jthompson2710/FireTIRS/README.md

# FireTIRS

This respository contains the hardware and software produced during the development of the Fire Thermal InfraRed Spectrometer (FireTIRS) imaging instrument as part of a NASA ESTO FireTech project (grant: 80NSSC23K1544)
