jthompson2710/FireTIRS/enclosures/readme.md

## FireTIRS Enclosures
This directory contains the design files for various enclosures used in the FireTIRS project.

### Zumlink Z9 T2 Enclosure
A simple 3D printed Freewave Zumlink Z9 T2 base station enclosure.  Designed using OpenSCAD and includes the generated STL.

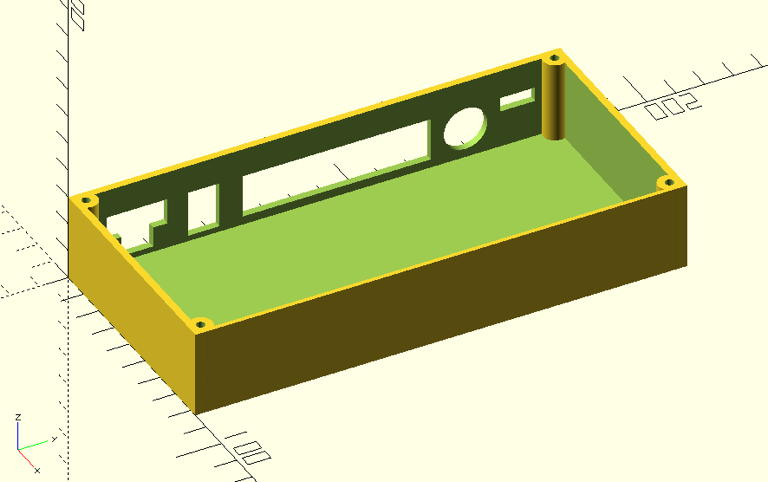
[picture p12: enclosures/pictures/t9_t2_encl_render.jpg]
Z9 T2 OpenSCAD render


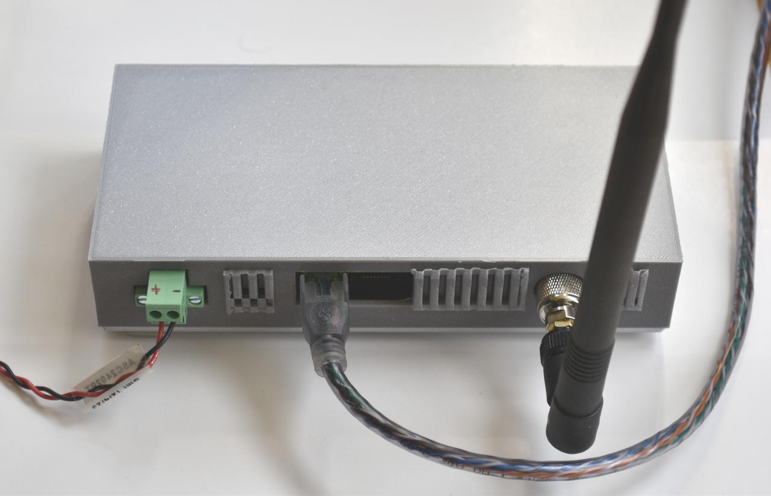
[picture p13: enclosures/pictures/z9_t2_enclosure.jpg]
Z9 T2 in enclosure


### FireTIRS UAV Enclosure
A 3D printable enclosure.  Designed using AutoCAD and includes the generated STLs.

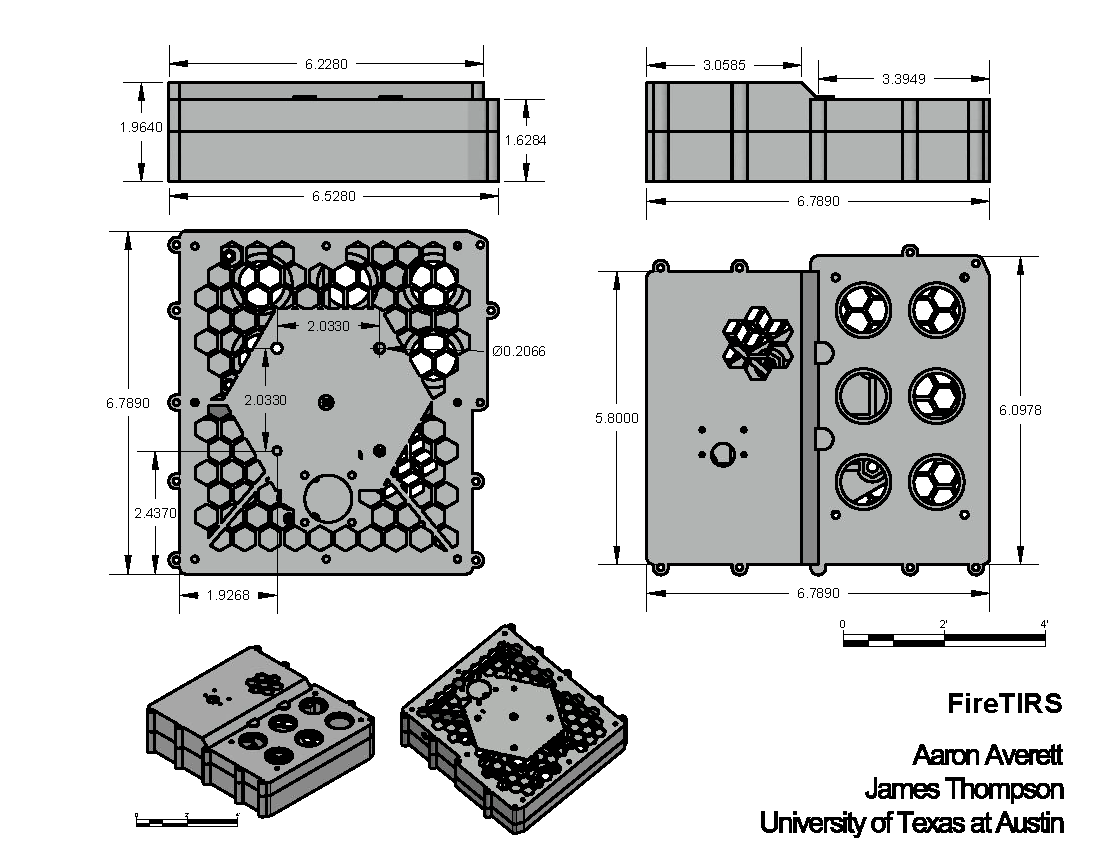
[picture p14: enclosures/pictures/FireTIRS_Dimensional.png]
FireTIRS Dimensional Render


FireTIRS enclosure base

FireTIRS enclosure top

FireTIRS enclosure filter retainer
