jthompson2710/FireTIRS/enclosures/pictures/housing_top.stl

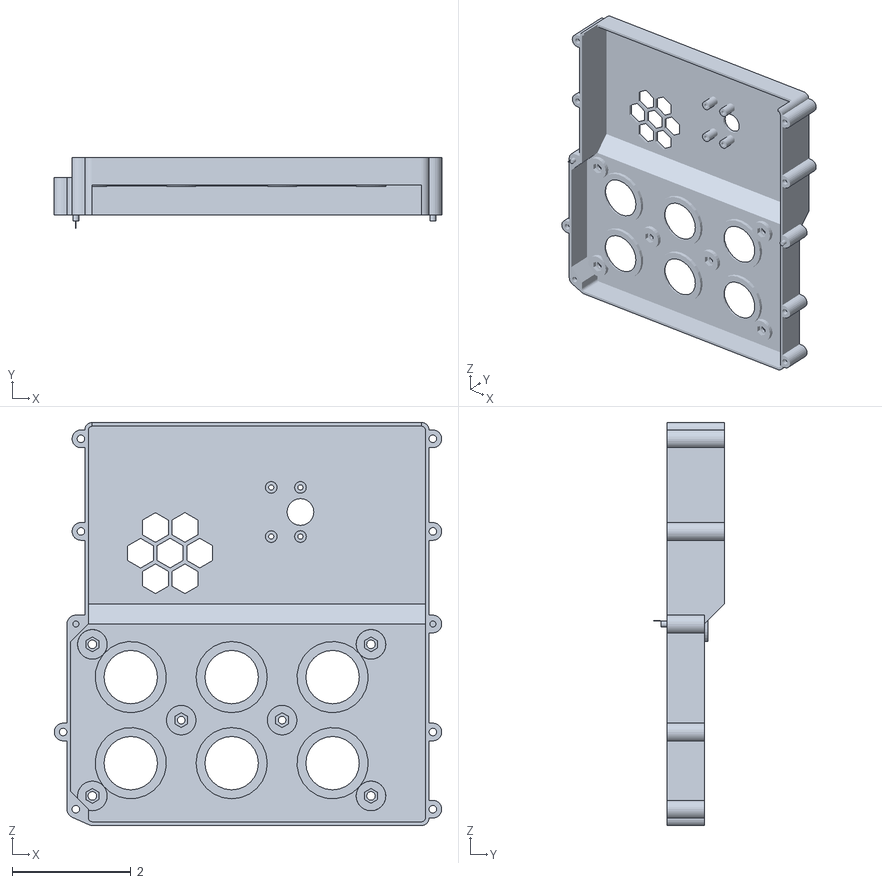
[picture p15: CAD file, 2025-01-29]
enclosures/pictures/housing_top.stl
6.53 x 1.19 x 6.79
