jthompson2710/FireTIRS/enclosures/z9_t2_enclosure/z9_t2_enclosure.stl

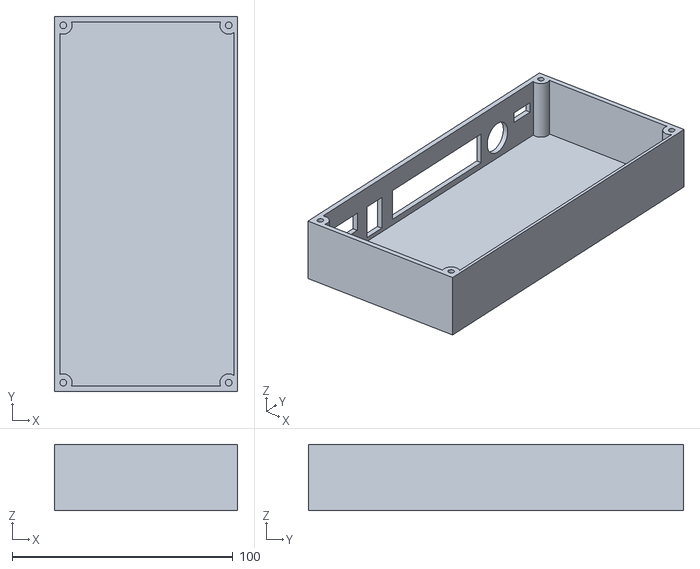
[picture p16: CAD file, 2024-07-04]
enclosures/z9_t2_enclosure/z9_t2_enclosure.stl
83.0 x 170.0 x 30.0
