jthompson2710/FireTIRS/enclosures/pictures/retainer.stl

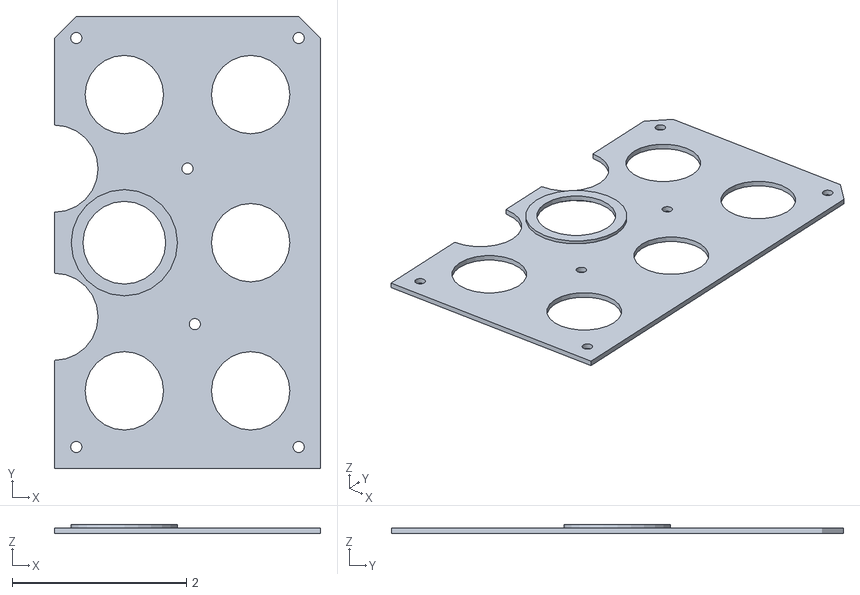
[picture p17: CAD file, 2025-01-29]
enclosures/pictures/retainer.stl
3.05 x 5.19 x 0.102
