jthompson2710/FireTIRS/enclosures/pictures/housing_base.stl

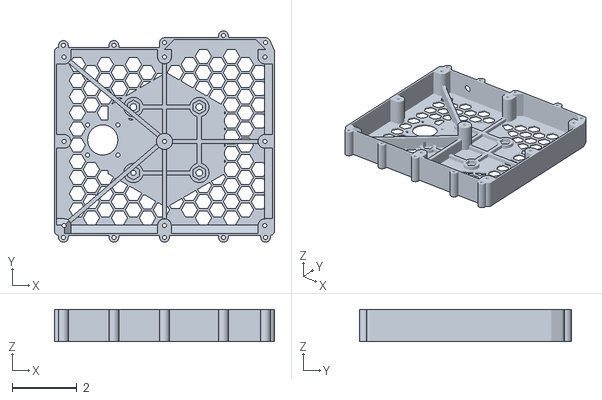
[picture p18: CAD file, 2025-01-29]
enclosures/pictures/housing_base.stl
6.79 x 6.53 x 1
