jthompson2710/FireTIRS/hardware/pcb_assembly/documentation/firetirs_pcb.pdf

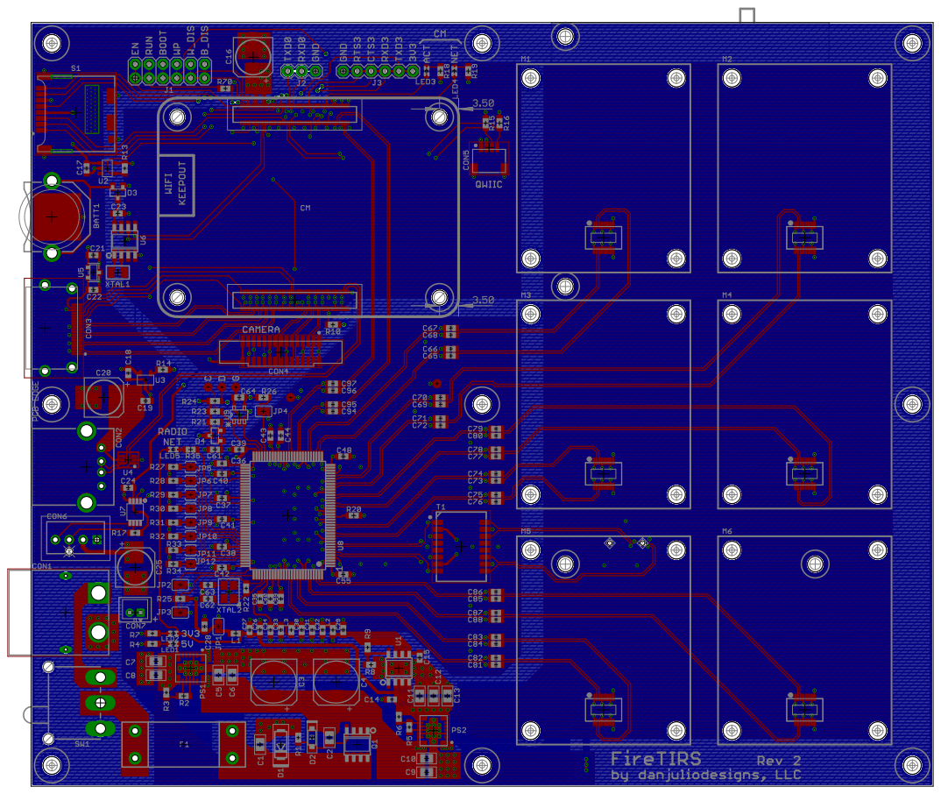
[picture p24: page 1]
