jthompson2710/FireTIRS/hardware/pcb_assembly/documentation/firetirs_schem.pdf

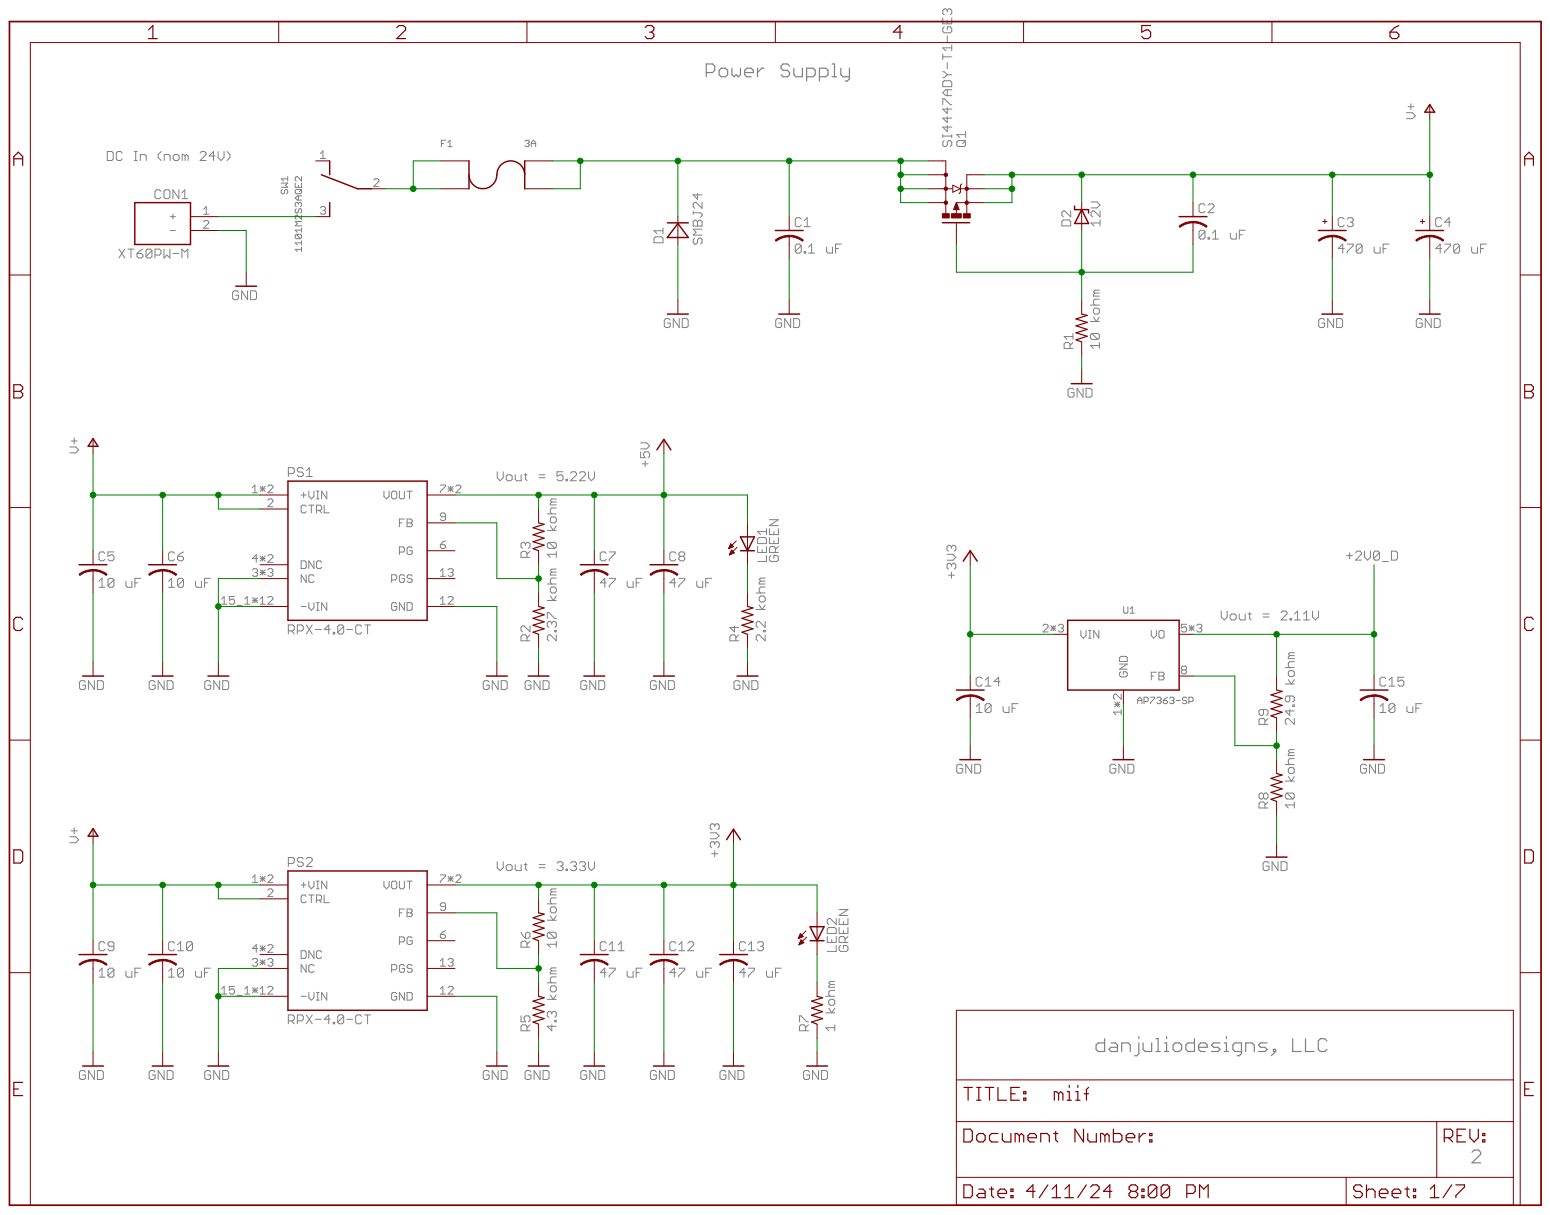
[picture p25: page 1]

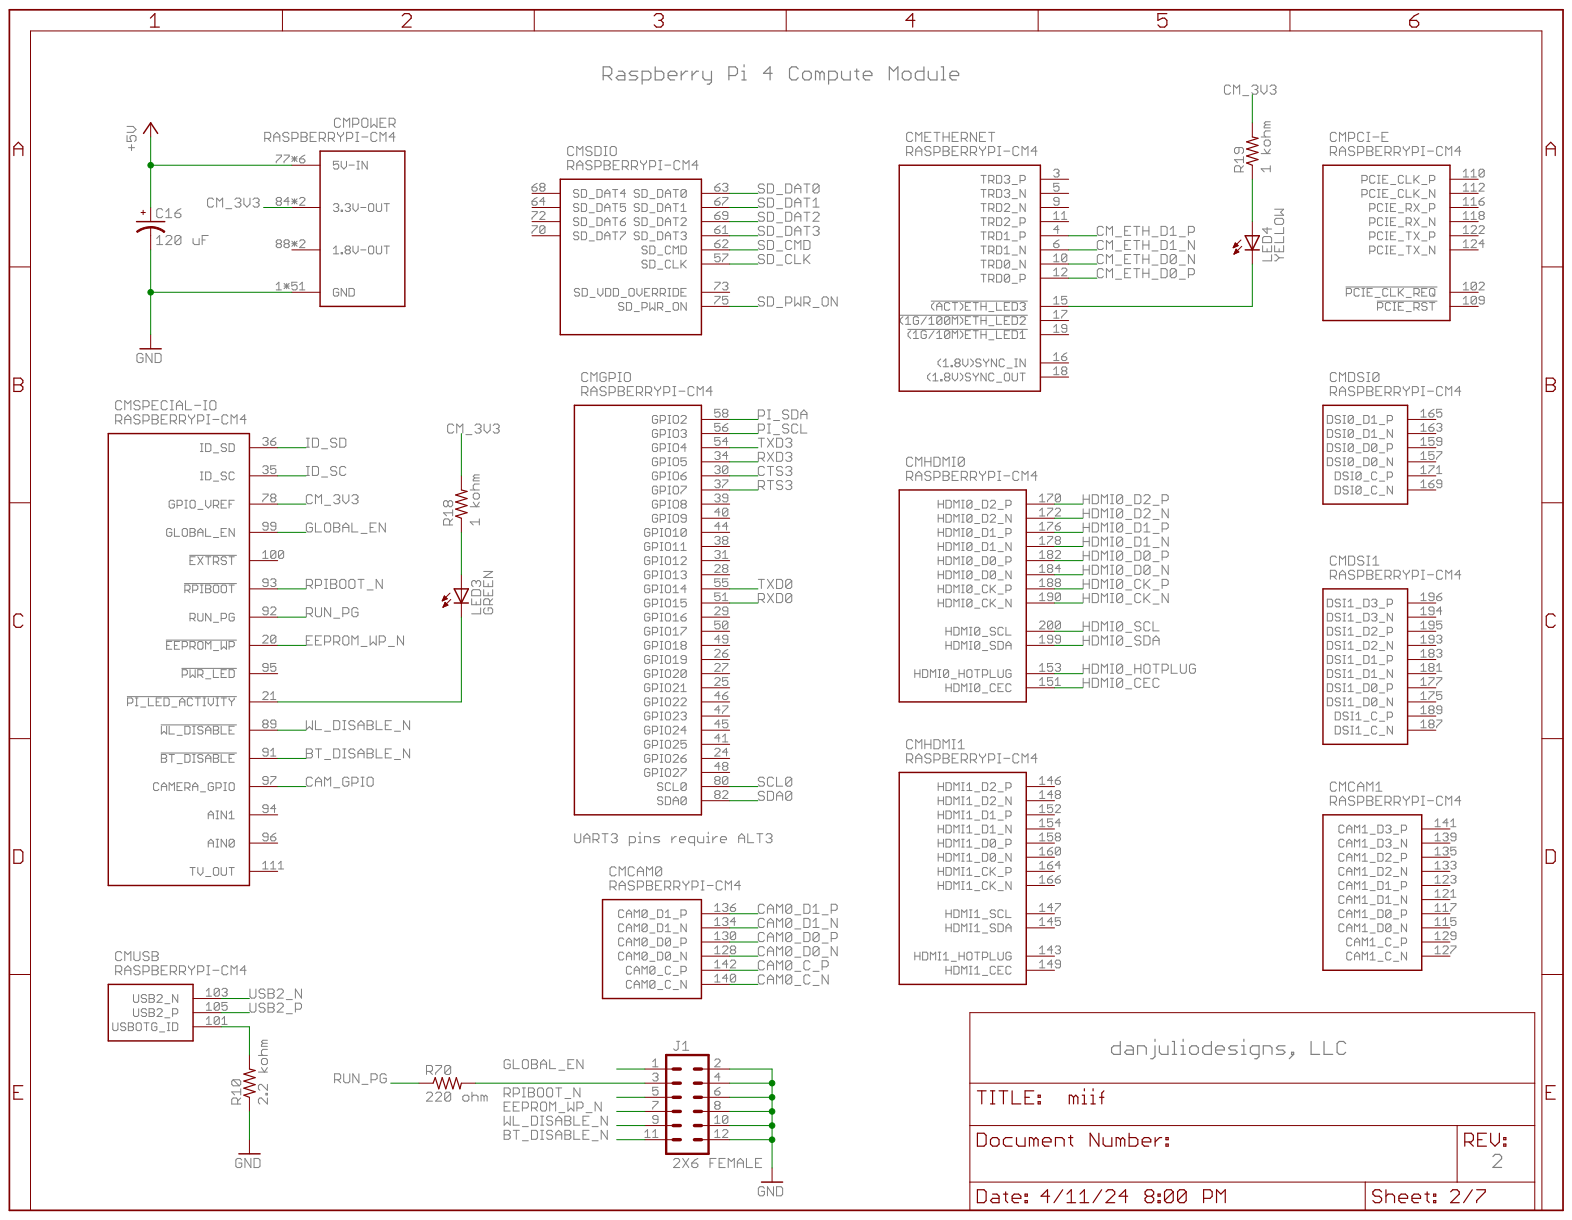
[picture p26: page 2]

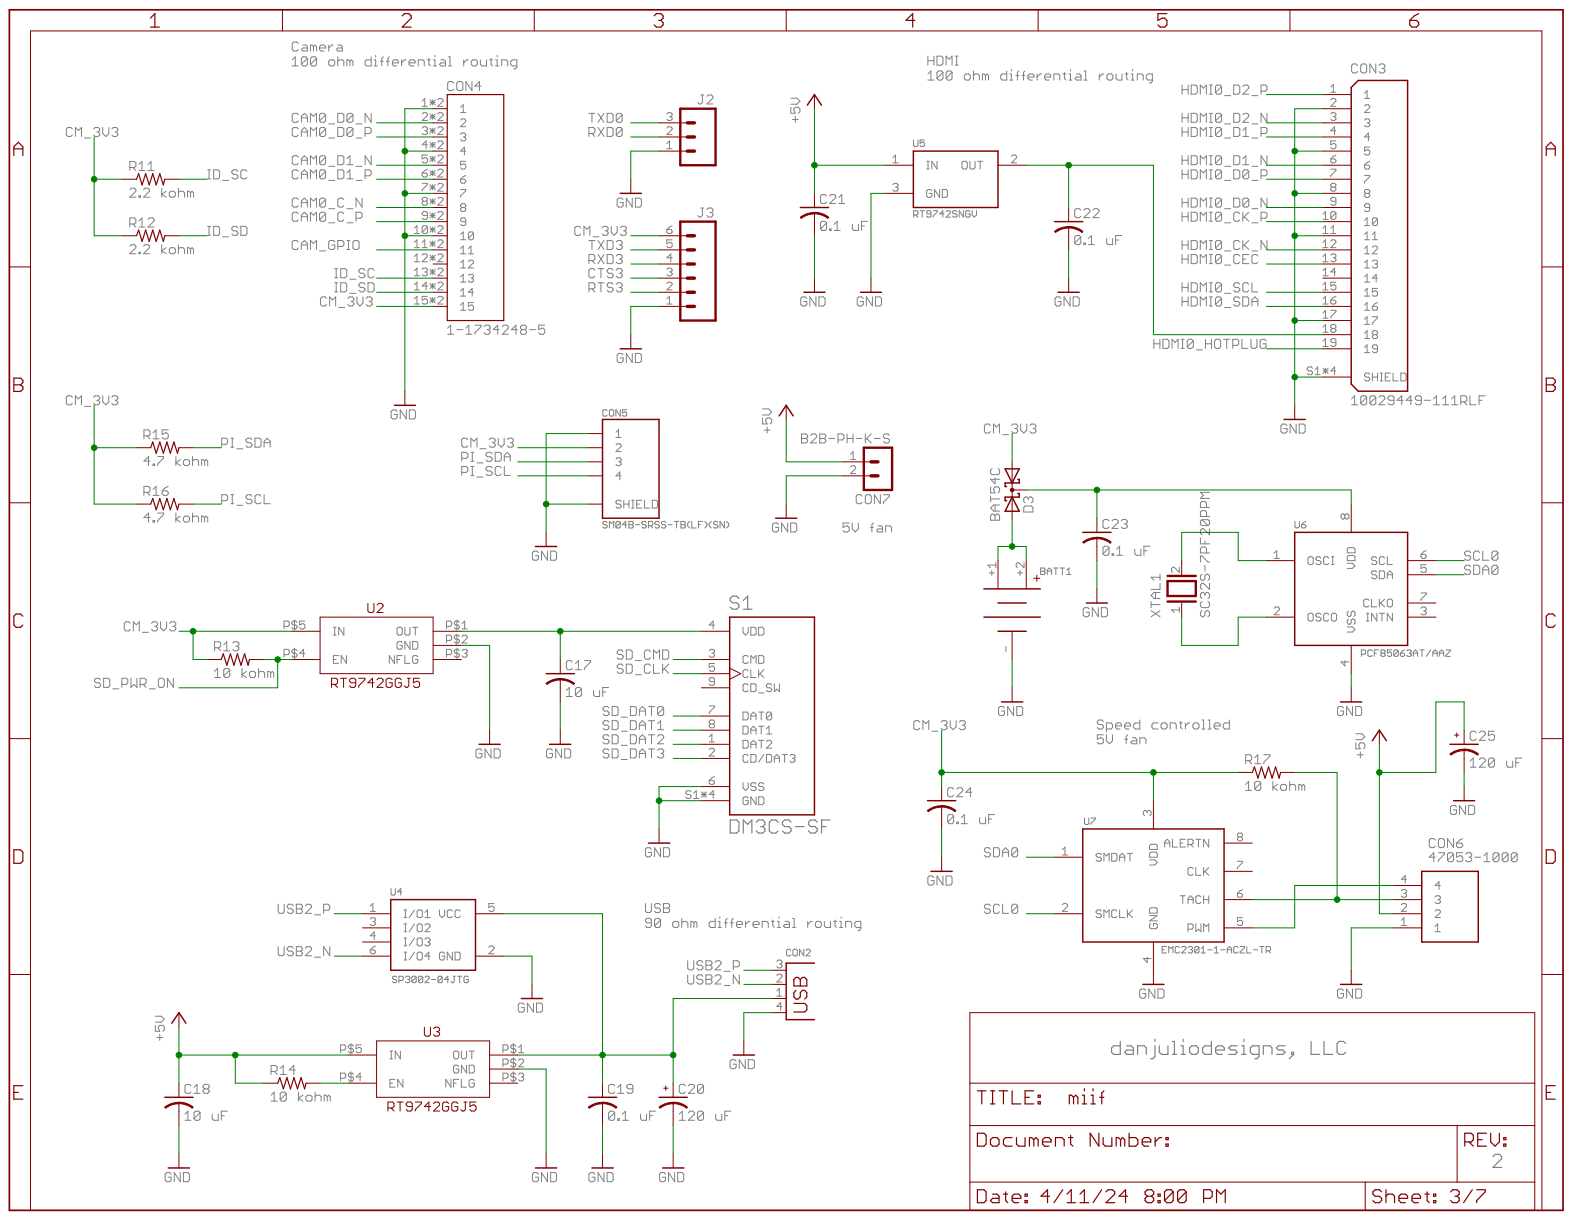
[picture p27: page 3]

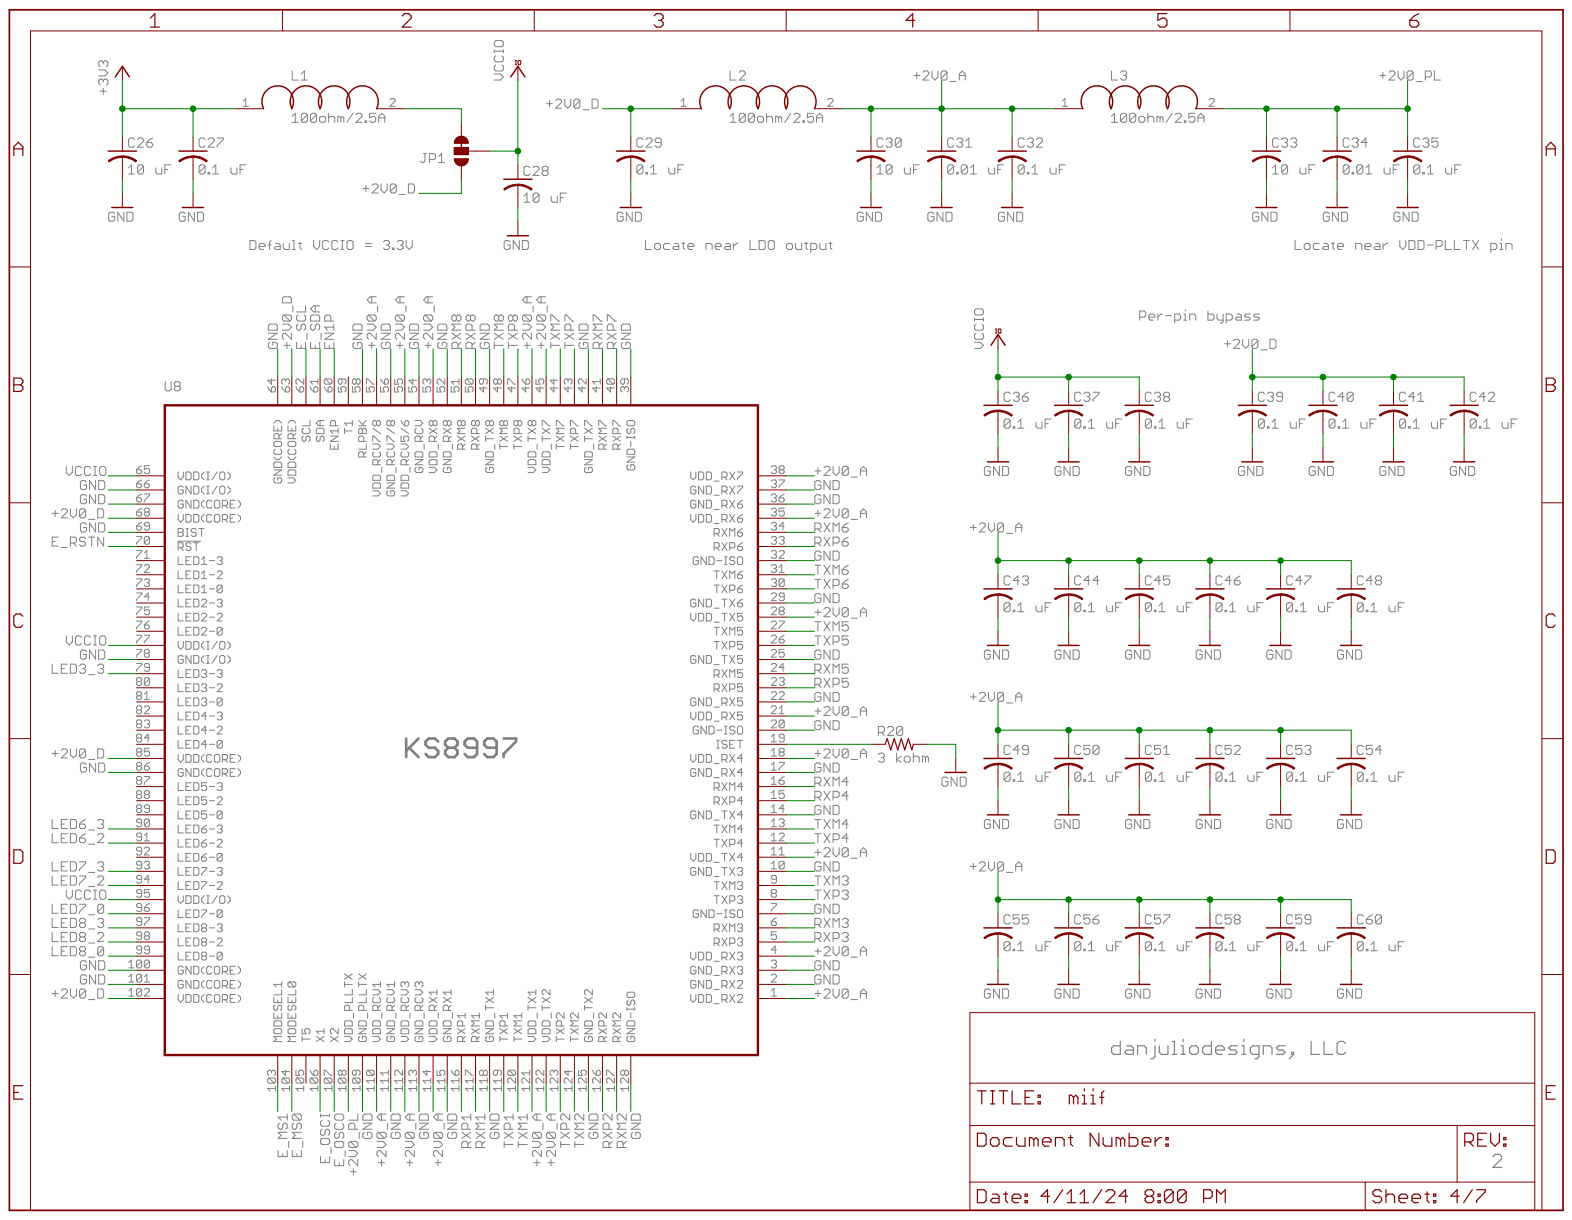
[picture p28: page 4]

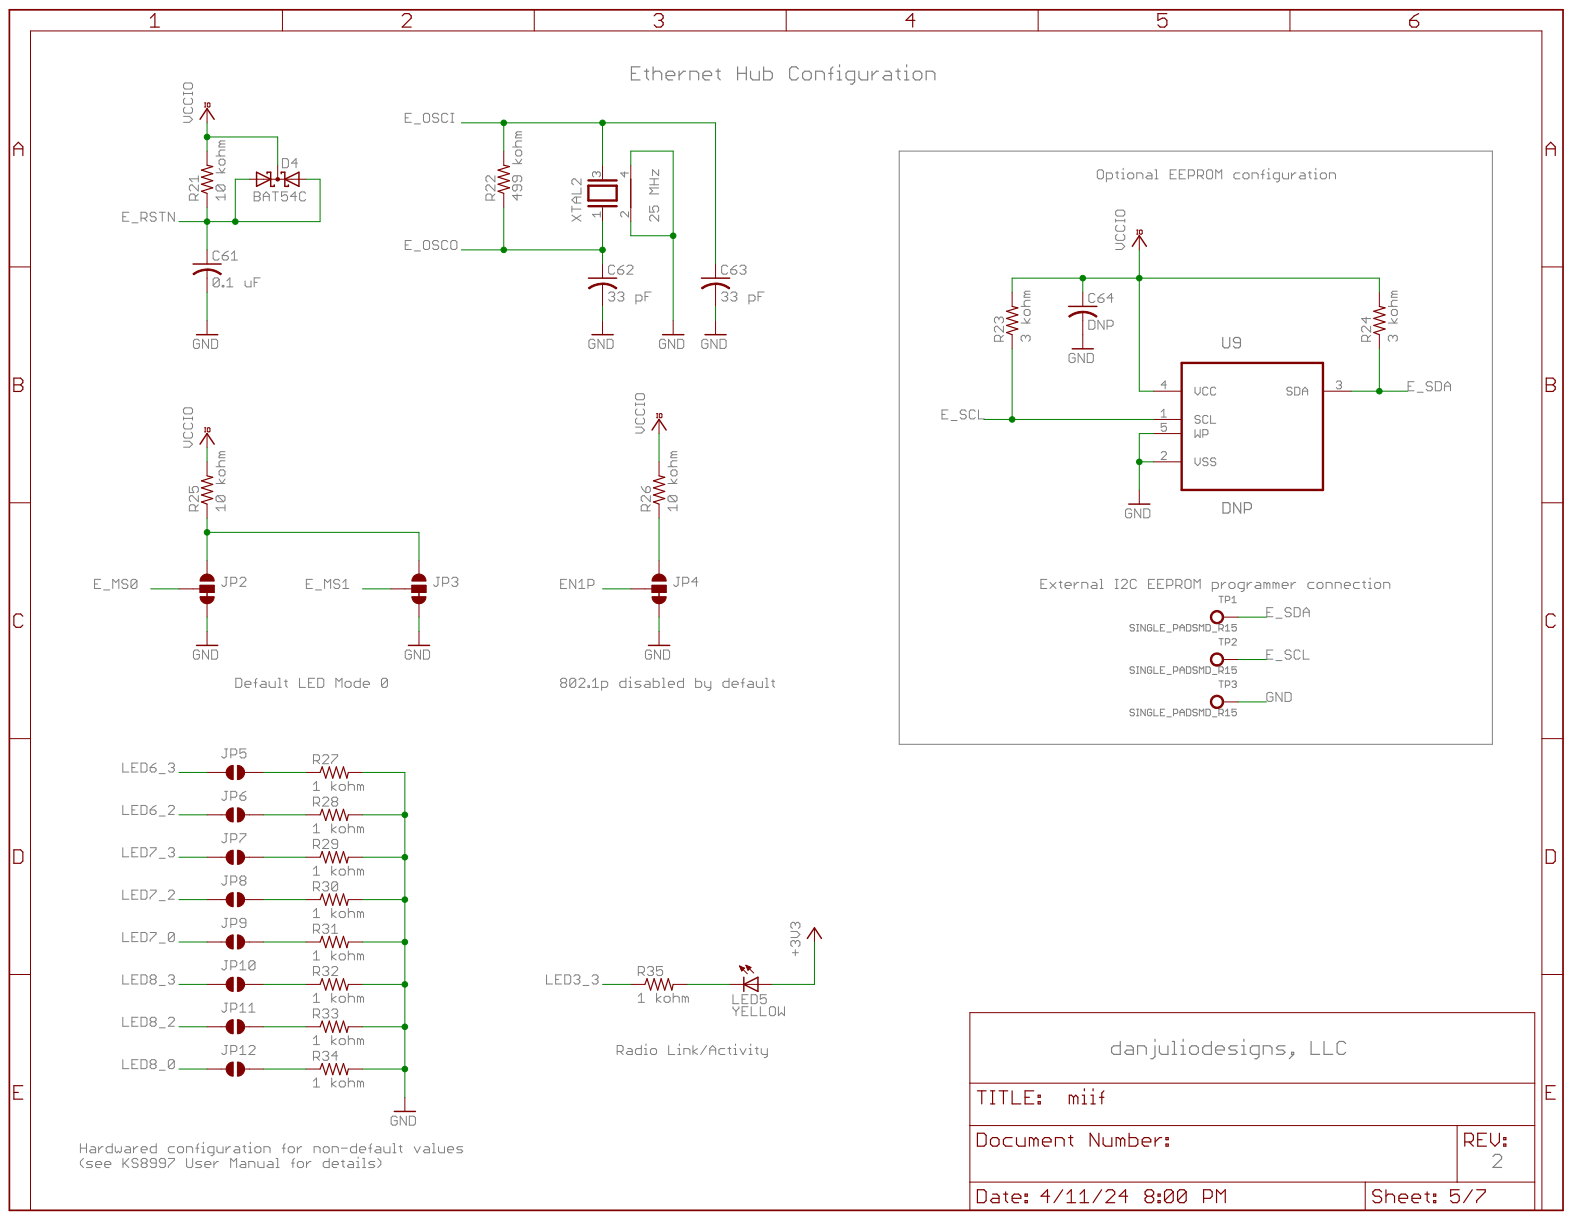
[picture p29: page 5]

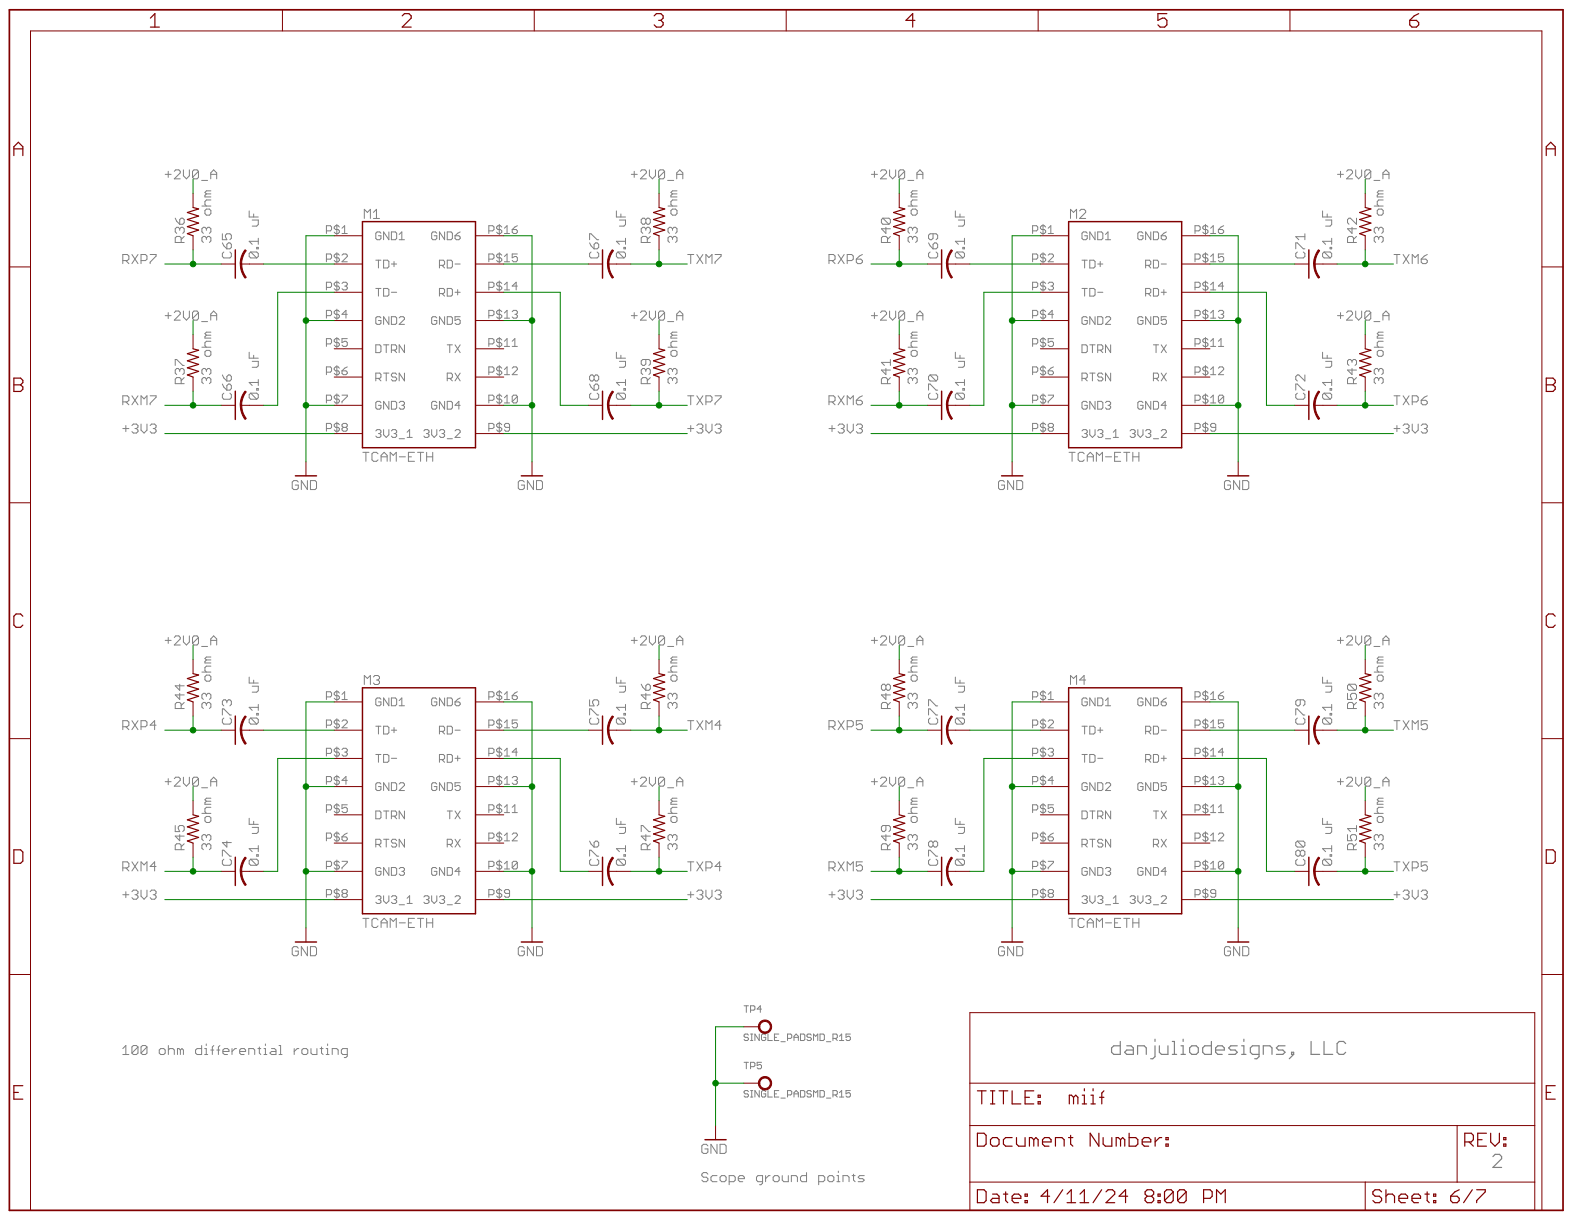
[picture p30: page 6]

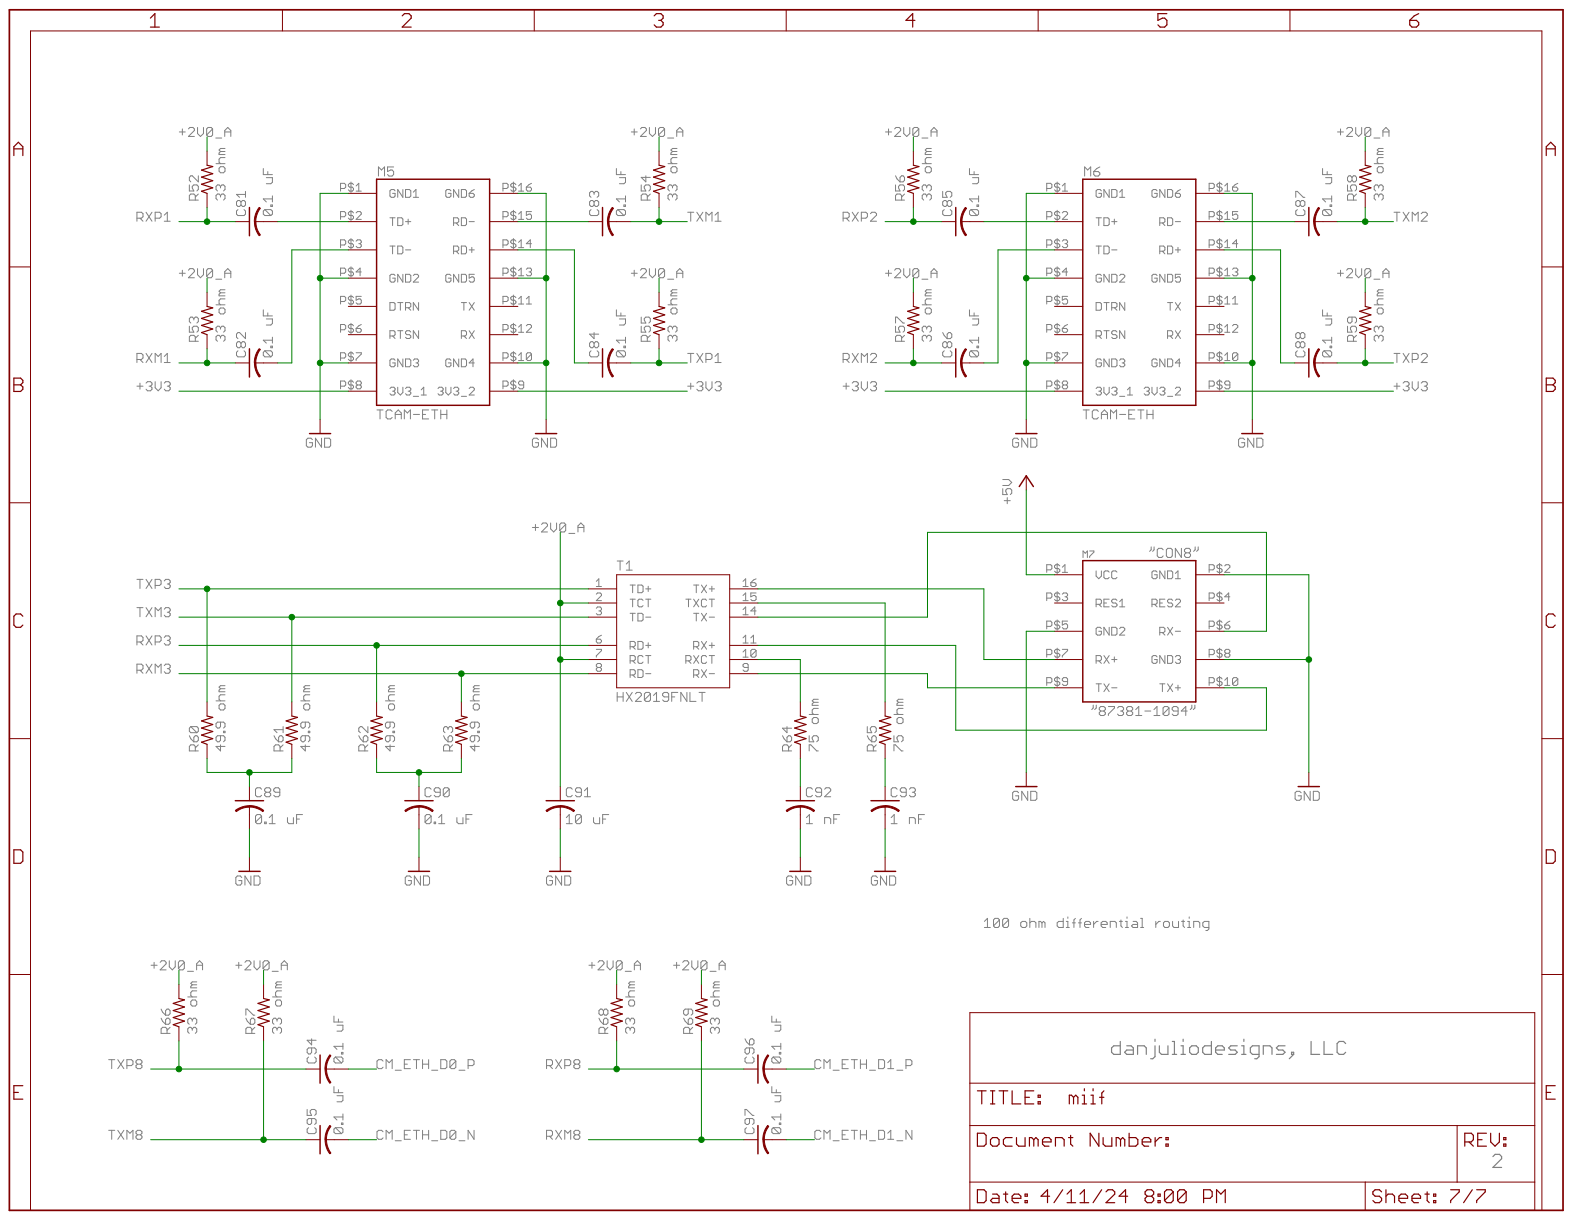
[picture p31: page 7]
