jthompson2710/FireTIRS/hardware/pcb_assembly/design/firetirs.brd

## EAGLE design hardware/pcb_assembly/design/firetirs.brd (2024-07-04)

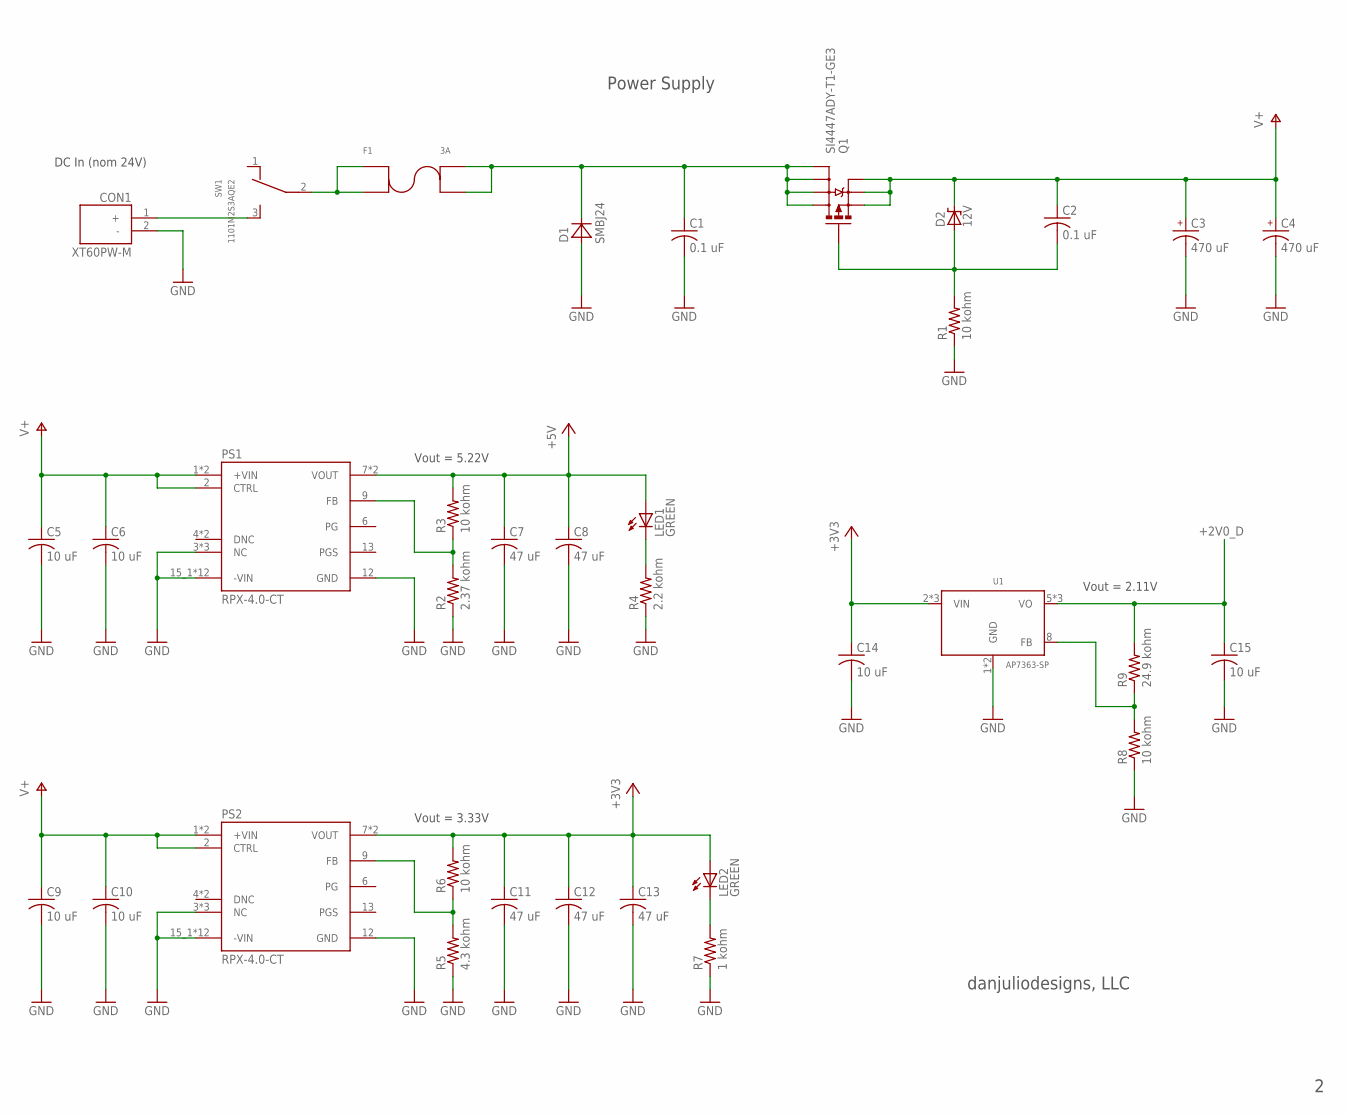
[picture p32: schematic firetirs.sch, sheet 1]

Parts:
C1, C2: 0.1 uF; C0805
C3, C4: 470 uF; ECAP-0810
C5, C6, C9, C10: 10 uF; C0805
C7, C8, C11, C12, C13: 47 uF; C0805
C14, C15: 10 uF; C0603
CON1: XT60PW-M; AMASS_XT60PW-M
D1: SMBJ24; DO214AA
D2: 12V; SOD123
F1: 3A; FUSE_5_20_MM_SIDE
LED1, LED2: GREEN; CHIPLED_0603
PS1, PS2: RPX-4.0-CT; CONV_RPX-4.0-CT
Q1: SI4447ADY-T1-GE3; SO8
R1, R3, R6, R8: 10 kohm; R0603
R2: 2.37 kohm; R0603
R4: 2.2 kohm; R0603
R5: 4.3 kohm; R0603
R7: 1 kohm; R0603
R9: 24.9 kohm; R0603
SW1: 1101M2S3AQE2; SIDE_PWR_SPDT
U1: AP7363-SP; SO8_PAD

Connections:
+2V0_D: C15.1, R9.2, U1.5 (VO), U1.6 (VO), U1.7 (VO); also elsewhere on the board
+3V3: C11.1, C12.1, C13.1, C14.1, LED2.A, PS2.7 (VOUT), PS2.8 (VOUT), R6.2, U1.2 (VIN), U1.3 (VIN), U1.4 (VIN); also elsewhere on the board
+5V: C7.1, C8.1, LED1.A, PS1.7 (VOUT), PS1.8 (VOUT), R3.2; also elsewhere on the board
GND: C1.2, C3.- (2), C4.- (2), C5.2, C6.2, C7.2, C8.2, C9.2, C10.2, C11.2, C12.2, C13.2, C14.2, C15.2, CON1.2 (-), D1.A, PS1.3 (NC), PS1.10 (NC), PS1.11 (NC), PS1.12 (GND), PS1.15_1 (-VIN), PS1.15_2 (-VIN), PS1.15_3 (-VIN), PS1.15_4 (-VIN), PS1.15_5 (-VIN), PS1.15_6 (-VIN), PS1.15_7 (-VIN), PS1.15_8 (-VIN), PS1.15_9 (-VIN), PS1.15_10 (-VIN), PS1.15_11 (-VIN), PS1.15_12 (-VIN), PS2.3 (NC), PS2.10 (NC), PS2.11 (NC), PS2.12 (GND), PS2.15_1 (-VIN), PS2.15_2 (-VIN), PS2.15_3 (-VIN), PS2.15_4 (-VIN), PS2.15_5 (-VIN), PS2.15_6 (-VIN), PS2.15_7 (-VIN), PS2.15_8 (-VIN), PS2.15_9 (-VIN), PS2.15_10 (-VIN), PS2.15_11 (-VIN), PS2.15_12 (-VIN), R1.1, R2.1, R4.1, R5.1, R7.1, R8.1, U1.1 (GND), U1.PAD (GND); also elsewhere on the board
unnamed: CON1.1 (+), SW1.3
unnamed: F1.1A (1), F1.1B (2), SW1.2
unnamed: C1.1, D1.C, F1.2A (3), F1.2B (4), Q1.5 (D1), Q1.6 (D2), Q1.7 (D3), Q1.8 (D4)
unnamed: C2.2, D2.A, Q1.4 (G), R1.2
unnamed: LED1.C, R4.2
unnamed: LED2.C, R7.2
unnamed: PS1.9 (FB), R2.2, R3.1
unnamed: R8.2, R9.1, U1.8 (FB)
unnamed: PS2.9 (FB), R5.2, R6.1
V+: C2.1, C3.+ (1), C4.+ (1), C5.1, C6.1, C9.1, C10.1, D2.C, PS1.1 (+VIN), PS1.2 (CTRL), PS1.14 (+VIN), PS2.1 (+VIN), PS2.2 (CTRL), PS2.14 (+VIN), Q1.1 (S1), Q1.2 (S2), Q1.3 (S3)

Notes on the sheet:
Vout = 5.22V
Vout = 3.33V
Power Supply
Vout = 2.11V
DC In (nom 24V)
danjuliodesigns, LLC

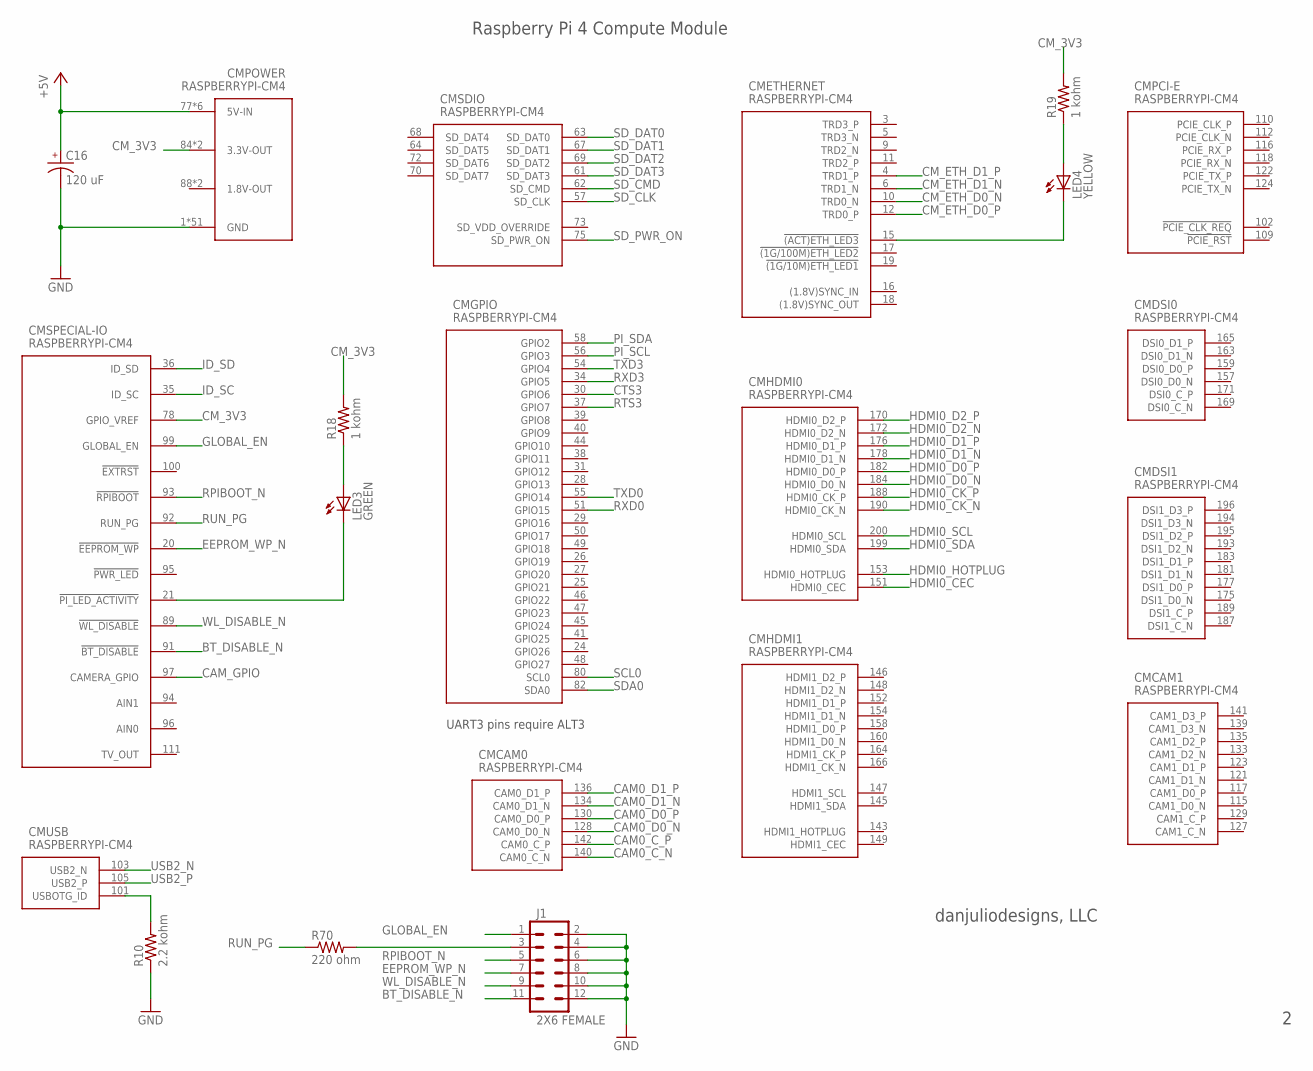
[picture p33: schematic firetirs.sch, sheet 2]

Parts:
C16: 120 uF; ECAP-0606
CM: RASPBERRYPI-CM4
J1: 2X6 FEMALE; 2X6
LED3: GREEN; CHIPLED_0603
LED4: YELLOW; CHIPLED_0603
R10: 2.2 kohm; R0603
R18, R19: 1 kohm; R0603
R70: 220 ohm; R0603

Connections:
1.8V-OUT: CM.88 (1.8V-OUT), CM.90 (1.8V-OUT)
+5V: C16.+ (1), CM.77 (5V-IN), CM.79 (5V-IN), CM.81 (5V-IN), CM.83 (5V-IN), CM.85 (5V-IN), CM.87 (5V-IN); also elsewhere on the board
BT_DISABLE_N: CM.91 (!BT_DISABLE), J1.11
CAM0_C_N: CM.140 (CAM0_C_N); also elsewhere on the board
CAM0_C_P: CM.142 (CAM0_C_P); also elsewhere on the board
CAM0_D0_N: CM.128 (CAM0_D0_N); also elsewhere on the board
CAM0_D0_P: CM.130 (CAM0_D0_P); also elsewhere on the board
CAM0_D1_N: CM.134 (CAM0_D1_N); also elsewhere on the board
CAM0_D1_P: CM.136 (CAM0_D1_P); also elsewhere on the board
CAM_GPIO: CM.97 (CAMERA_GPIO); also elsewhere on the board
CM_3V3: CM.78 (GPIO_VREF), CM.84 (3.3V-OUT), CM.86 (3.3V-OUT), R18.2, R19.2; also elsewhere on the board
CM_ETH_D0_N: CM.10 (TRD0_N); also elsewhere on the board
CM_ETH_D0_P: CM.12 (TRD0_P); also elsewhere on the board
CM_ETH_D1_N: CM.6 (TRD1_N); also elsewhere on the board
CM_ETH_D1_P: CM.4 (TRD1_P); also elsewhere on the board
CTS3: CM.30 (GPIO6); also elsewhere on the board
EEPROM_WP_N: CM.20 (!EEPROM_WP), J1.7
GLOBAL_EN: CM.99 (GLOBAL_EN), J1.1
GND: C16.- (2), CM.1 (GND), CM.2 (GND), CM.7 (GND), CM.8 (GND), CM.13 (GND), CM.14 (GND), CM.22 (GND), CM.23 (GND), CM.32 (GND), CM.33 (GND), CM.42 (GND), CM.43 (GND), CM.52 (GND), CM.53 (GND), CM.59 (GND), CM.60 (GND), CM.65 (GND), CM.66 (GND), CM.71 (GND), CM.74 (GND), CM.98 (GND), CM.107 (GND), CM.108 (GND), CM.113 (GND), CM.114 (GND), CM.119 (GND), CM.120 (GND), CM.125 (GND), CM.126 (GND), CM.131 (GND), CM.132 (GND), CM.137 (GND), CM.138 (GND), CM.144 (GND), CM.150 (GND), CM.155 (GND), CM.156 (GND), CM.161 (GND), CM.162 (GND), CM.167 (GND), CM.168 (GND), CM.173 (GND), CM.174 (GND), CM.179 (GND), CM.180 (GND), CM.185 (GND), CM.186 (GND), CM.191 (GND), CM.192 (GND), CM.197 (GND), CM.198 (GND), J1.2, J1.4, J1.6, J1.8, J1.10, J1.12, R10.1; also elsewhere on the board
HDMI0_CEC: CM.151 (HDMI0_CEC); also elsewhere on the board
HDMI0_CK_N: CM.190 (HDMI0_CK_N); also elsewhere on the board
HDMI0_CK_P: CM.188 (HDMI0_CK_P); also elsewhere on the board
HDMI0_D0_N: CM.184 (HDMI0_D0_N); also elsewhere on the board
HDMI0_D0_P: CM.182 (HDMI0_D0_P); also elsewhere on the board
HDMI0_D1_N: CM.178 (HDMI0_D1_N); also elsewhere on the board
HDMI0_D1_P: CM.176 (HDMI0_D1_P); also elsewhere on the board
HDMI0_D2_N: CM.172 (HDMI0_D2_N); also elsewhere on the board
HDMI0_D2_P: CM.170 (HDMI0_D2_P); also elsewhere on the board
HDMI0_HOTPLUG: CM.153 (HDMI0_HOTPLUG); also elsewhere on the board
HDMI0_SCL: CM.200 (HDMI0_SCL); also elsewhere on the board
HDMI0_SDA: CM.199 (HDMI0_SDA); also elsewhere on the board
ID_SC: CM.35 (ID_SC); also elsewhere on the board
ID_SD: CM.36 (ID_SD); also elsewhere on the board
unnamed: CM.101 (USBOTG_ID), R10.2
unnamed: CM.21 (!PI_LED_ACTIVITY), LED3.C
unnamed: LED3.A, R18.1
unnamed: CM.15 (!(ACT)ETH_LED3), LED4.C
unnamed: LED4.A, R19.1
unnamed: J1.3, R70.2
PI_SCL: CM.56 (GPIO3); also elsewhere on the board
PI_SDA: CM.58 (GPIO2); also elsewhere on the board
RPIBOOT_N: CM.93 (!RPIBOOT), J1.5
RTS3: CM.37 (GPIO7); also elsewhere on the board
RUN_PG: CM.92 (RUN_PG), R70.1
RXD0: CM.51 (GPIO15); also elsewhere on the board
RXD3: CM.34 (GPIO5); also elsewhere on the board
SCL0: CM.80 (SCL0); also elsewhere on the board
SDA0: CM.82 (SDA0); also elsewhere on the board
SD_CLK: CM.57 (SD_CLK); also elsewhere on the board
SD_CMD: CM.62 (SD_CMD); also elsewhere on the board
SD_DAT0: CM.63 (SD_DAT0); also elsewhere on the board
SD_DAT1: CM.67 (SD_DAT1); also elsewhere on the board
SD_DAT2: CM.69 (SD_DAT2); also elsewhere on the board
SD_DAT3: CM.61 (SD_DAT3); also elsewhere on the board
SD_PWR_ON: CM.75 (SD_PWR_ON); also elsewhere on the board
TXD0: CM.55 (GPIO14); also elsewhere on the board
TXD3: CM.54 (GPIO4); also elsewhere on the board
USB2_N: CM.103 (USB2_N); also elsewhere on the board
USB2_P: CM.105 (USB2_P); also elsewhere on the board
WL_DISABLE_N: CM.89 (!WL_DISABLE), J1.9

Notes on the sheet:
Raspberry Pi 4 Compute Module
UART3 pins require ALT3
danjuliodesigns, LLC

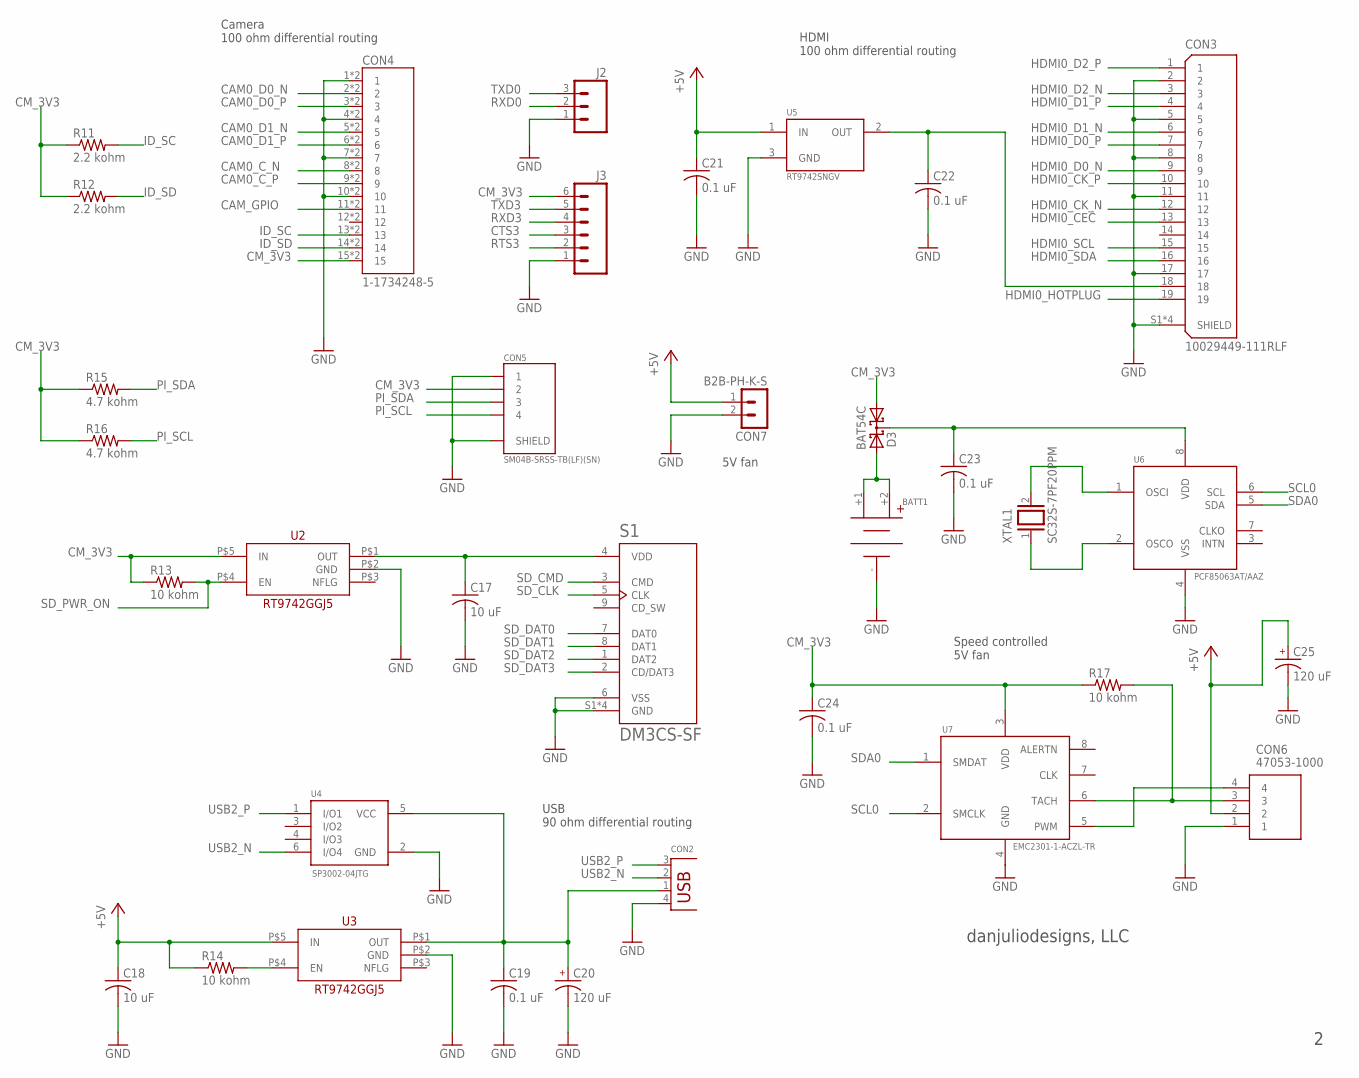
[picture p34: schematic firetirs.sch, sheet 3]

Parts:
BATT1: COIN_CELL12MM; KEYSTONE_3001
C17, C18: 10 uF; C0603
C19, C21, C22, C23, C24: 0.1 uF; C0603
C20, C25: 120 uF; ECAP-0606
CON2: USBFCI_87520; FCI_87520
CON3: 10029449-111RLF; AMPHENOL_10029449-111RLF
CON4: 1-1734248-5; TE_1-1734248-5
CON5: SM04B-SRSS-TB(LF)(SN); JST_SM04B-SRSS-TB(LF)(SN)
CON6: 47053-1000; 470531000
CON7: B2B-PH-K-S
D3: BAT54C; SOT23
J2: M03PTH; 1X03
J3: M06SILK_FEMALE_PTH; 1X06
R11, R12: 2.2 kohm; R0603
R13, R14, R17: 10 kohm; R0603
R15, R16: 4.7 kohm; R0603
S1: DM3CS-SF; HRS_DM3CS-SF
U2, U3: RT9742GGJ5; TSOT-23-5
U4: SP3002-04JTG; SOT65P220X95-6N
U5: RT9742SNGV; SOT23-3
U6: PCF85063AT/AAZ; SO8
U7: EMC2301-1-ACZL-TR; MSOP8
XTAL1: SC32S-7PF20PPM; CRYSTAL-3215

Connections:
+5V: C18.1, C21.1, C25.+ (1), CON6.2, CON7.1, R14.1, U3.P$5 (IN), U5.1 (IN); also elsewhere on the board
CAM0_C_N: CON4.8, CON4.8_1 (8); also elsewhere on the board
CAM0_C_P: CON4.9, CON4.9_1 (9); also elsewhere on the board
CAM0_D0_N: CON4.2, CON4.2_1 (2); also elsewhere on the board
CAM0_D0_P: CON4.3, CON4.3_1 (3); also elsewhere on the board
CAM0_D1_N: CON4.5, CON4.5_1 (5); also elsewhere on the board
CAM0_D1_P: CON4.6, CON4.6_1 (6); also elsewhere on the board
CAM_GPIO: CON4.11, CON4.11_1 (11); also elsewhere on the board
CM_3V3: C24.1, CON4.15, CON4.15_1 (15), CON5.2, D3.1 (A1), J3.6, R11.1, R12.1, R13.1, R15.1, R16.1, R17.1, U2.P$5 (IN), U7.3 (VDD); also elsewhere on the board
CTS3: J3.3; also elsewhere on the board
GND: BATT1.-, C17.2, C18.2, C19.2, C20.- (2), C21.2, C22.2, C23.2, C24.2, C25.- (2), CON2.4 (GND), CON3.2, CON3.5, CON3.8, CON3.11, CON3.17, CON3.S1 (SHIELD), CON3.S2 (SHIELD), CON3.S3 (SHIELD), CON3.S4 (SHIELD), CON4.1, CON4.1_1 (1), CON4.4, CON4.4_1 (4), CON4.7, CON4.7_1 (7), CON4.10, CON4.10_1 (10), CON5.1, CON5.S1 (SHIELD), CON5.S2 (SHIELD), CON6.1, CON7.2, J2.1, J3.1, S1.6 (VSS), S1.S1 (GND), S1.S2 (GND), S1.S3 (GND), S1.S5 (GND), U2.P$2 (GND), U3.P$2 (GND), U4.2 (GND), U5.3 (GND), U6.4 (VSS), U7.4 (GND); also elsewhere on the board
HDMI0_CEC: CON3.13; also elsewhere on the board
HDMI0_CK_N: CON3.12; also elsewhere on the board
HDMI0_CK_P: CON3.10; also elsewhere on the board
HDMI0_D0_N: CON3.9; also elsewhere on the board
HDMI0_D0_P: CON3.7; also elsewhere on the board
HDMI0_D1_N: CON3.6; also elsewhere on the board
HDMI0_D1_P: CON3.4; also elsewhere on the board
HDMI0_D2_N: CON3.3; also elsewhere on the board
HDMI0_D2_P: CON3.1; also elsewhere on the board
HDMI0_HOTPLUG: CON3.19; also elsewhere on the board
HDMI0_SCL: CON3.15; also elsewhere on the board
HDMI0_SDA: CON3.16; also elsewhere on the board
ID_SC: CON4.13, CON4.13_1 (13), R11.2; also elsewhere on the board
ID_SD: CON4.14, CON4.14_1 (14), R12.2; also elsewhere on the board
unnamed: C17.1, S1.4 (VDD), U2.P$1 (OUT)
unnamed: C19.1, C20.+ (1), CON2.1 (VBUS), U3.P$1 (OUT), U4.5 (VCC)
unnamed: U6.2 (OSCO), XTAL1.1
unnamed: BATT1.+1, BATT1.+2, D3.2 (A2)
unnamed: U6.1 (OSCI), XTAL1.2
unnamed: CON6.3, R17.2, U7.6 (TACH)
unnamed: CON6.4, U7.5 (PWM)
unnamed: R14.2, U3.P$4 (EN)
OUT: C22.1, CON3.18, U5.2 (OUT)
PI_SCL: CON5.4, R16.2; also elsewhere on the board
PI_SDA: CON5.3, R15.2; also elsewhere on the board
RTS3: J3.2; also elsewhere on the board
RXD0: J2.2; also elsewhere on the board
RXD3: J3.4; also elsewhere on the board
SCL0: U6.6 (SCL), U7.2 (SMCLK); also elsewhere on the board
SDA0: U6.5 (SDA), U7.1 (SMDAT); also elsewhere on the board
SD_CLK: S1.5 (CLK); also elsewhere on the board
SD_CMD: S1.3 (CMD); also elsewhere on the board
SD_DAT0: S1.7 (DAT0); also elsewhere on the board
SD_DAT1: S1.8 (DAT1); also elsewhere on the board
SD_DAT2: S1.1 (DAT2); also elsewhere on the board
SD_DAT3: S1.2 (CD/DAT3); also elsewhere on the board
SD_PWR_ON: R13.2, U2.P$4 (EN); also elsewhere on the board
TXD0: J2.3; also elsewhere on the board
TXD3: J3.5; also elsewhere on the board
USB2_N: CON2.2 (D-), U4.6 (I/O4); also elsewhere on the board
USB2_P: CON2.3 (D+), U4.1 (I/O1); also elsewhere on the board
VDD: C23.1, D3.3 (CC), U6.8 (VDD)

Notes on the sheet:
Camera 100 ohm differential routing
USB 90 ohm differential routing
HDMI 100 ohm differential routing
Speed controlled 5V fan
5V fan
danjuliodesigns, LLC

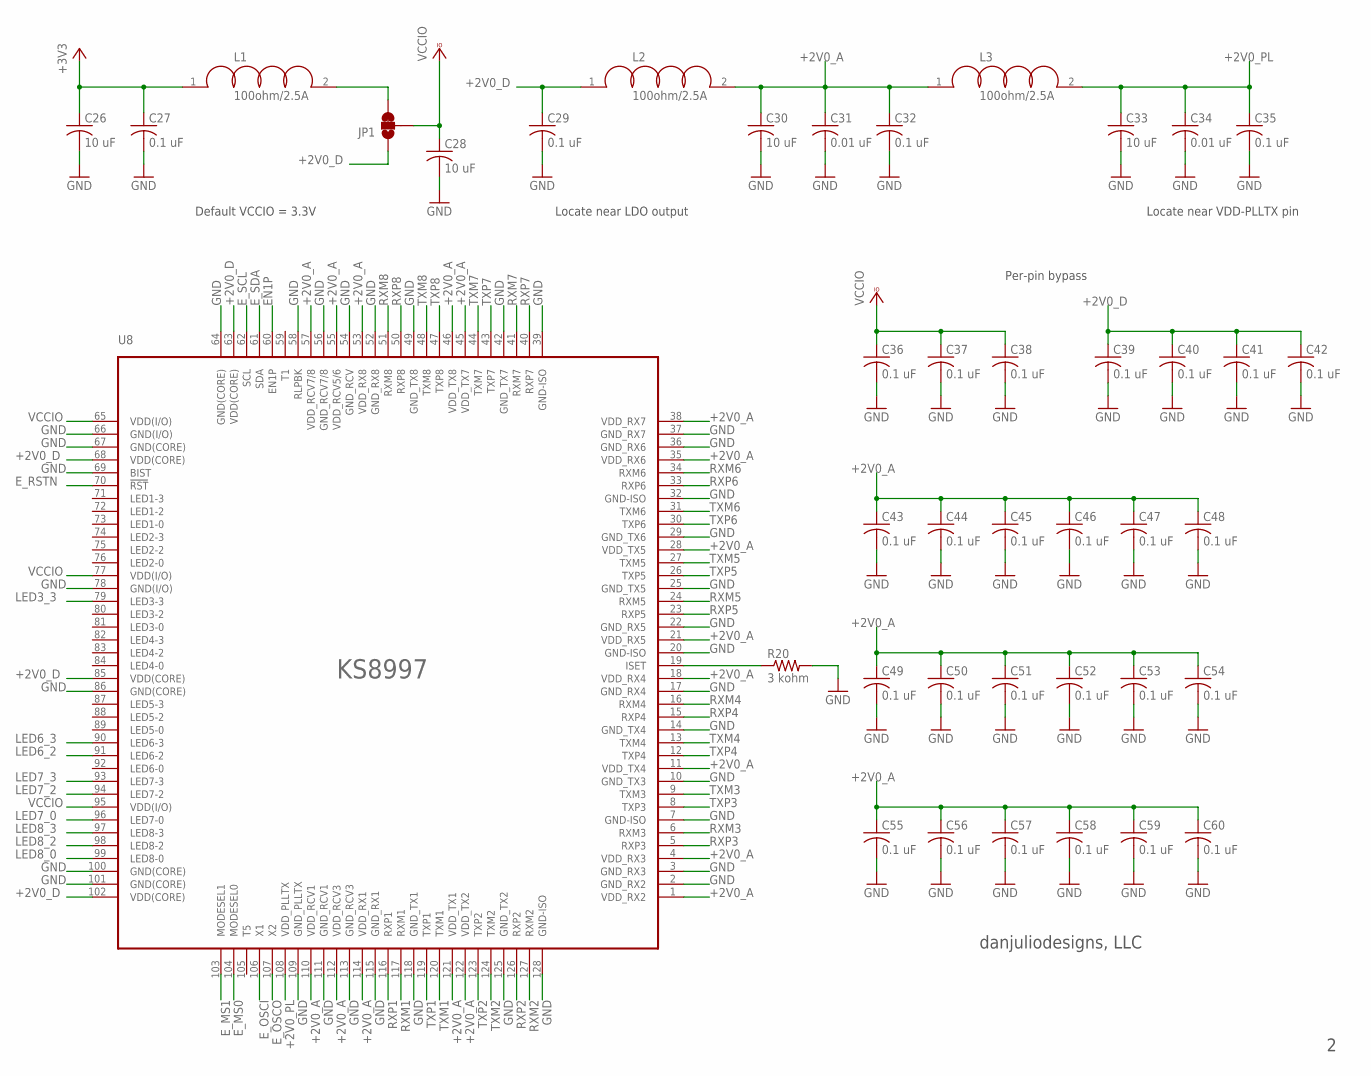
[picture p35: schematic firetirs.sch, sheet 4]

Parts:
C26, C28, C30, C33: 10 uF; C0603
C27, C29, C32, C35, C36, C37, C38, C39, C40, C41, C42, C43, C44, C45, C46, C47, C48, C49, C50, C51, C52, C53, C54, C55, C56, C57, C58, C59, C60: 0.1 uF; C0603
C31, C34: 0.01 uF; C0603
JP1: JUMPER-PAD-3-2OF3_NC_BY_TRACE_SMALL; PAD-JUMPER-3-2OF3_NC_BY_TRACE_YES_SILK_FULL_BOX
L1, L2, L3: 100ohm/2.5A; L0603
R20: 3 kohm; R0603
U8: KS8997; PQFP128-PQ

Connections:
+2V0_A: C30.1, C31.1, C32.1, C43.1, C44.1, C45.1, C46.1, C47.1, C48.1, C49.1, C50.1, C51.1, C52.1, C53.1, C54.1, C55.1, C56.1, C57.1, C58.1, C59.1, C60.1, L2.2, L3.1, U8.1 (VDD_RX2), U8.4 (VDD_RX3), U8.11 (VDD_TX4), U8.18 (VDD_RX4), U8.21 (VDD_RX5), U8.28 (VDD_TX5), U8.35 (VDD_RX6), U8.38 (VDD_RX7), U8.45 (VDD_TX7), U8.46 (VDD_TX8), U8.53 (VDD_RX8), U8.55 (VDD_RCV5/6), U8.57 (VDD_RCV7/8), U8.110 (VDD_RCV1), U8.112 (VDD_RCV3), U8.114 (VDD_RX1), U8.121 (VDD_TX1), U8.122 (VDD_TX2); also elsewhere on the board
+2V0_D: C29.1, C39.1, C40.1, C41.1, C42.1, JP1.1, L2.1, U8.63 (VDD(CORE)), U8.68 (VDD(CORE)), U8.85 (VDD(CORE)), U8.102 (VDD(CORE)); also elsewhere on the board
+2V0_PL: C33.1, C34.1, C35.1, L3.2, U8.108 (VDD_PLLTX)
+3V3: C26.1, C27.1, L1.1; also elsewhere on the board
EN1P: U8.60 (EN1P); also elsewhere on the board
E_MS0: U8.104 (MODESEL0); also elsewhere on the board
E_MS1: U8.103 (MODESEL1); also elsewhere on the board
E_OSCI: U8.106 (X1); also elsewhere on the board
E_OSCO: U8.107 (X2); also elsewhere on the board
E_RSTN: U8.70 (!RST!); also elsewhere on the board
E_SCL: U8.62 (SCL); also elsewhere on the board
E_SDA: U8.61 (SDA); also elsewhere on the board
GND: C26.2, C27.2, C28.2, C29.2, C30.2, C31.2, C32.2, C33.2, C34.2, C35.2, C36.2, C37.2, C38.2, C39.2, C40.2, C41.2, C42.2, C43.2, C44.2, C45.2, C46.2, C47.2, C48.2, C49.2, C50.2, C51.2, C52.2, C53.2, C54.2, C55.2, C56.2, C57.2, C58.2, C59.2, C60.2, R20.2, U8.2 (GND_RX2), U8.3 (GND_RX3), U8.7 (GND-ISO), U8.10 (GND_TX3), U8.14 (GND_TX4), U8.17 (GND_RX4), U8.20 (GND-ISO), U8.22 (GND_RX5), U8.25 (GND_TX5), U8.29 (GND_TX6), U8.32 (GND-ISO), U8.36 (GND_RX6), U8.37 (GND_RX7), U8.39 (GND-ISO), U8.42 (GND_TX7), U8.49 (GND_TX8), U8.52 (GND_RX8), U8.54 (GND_RCV), U8.56 (GND_RCV7/8), U8.58 (RLPBK), U8.64 (GND(CORE)), U8.66 (GND(I/O)), U8.67 (GND(CORE)), U8.69 (BIST), U8.78 (GND(I/O)), U8.86 (GND(CORE)), U8.100 (GND(CORE)), U8.101 (GND(CORE)), U8.109 (GND_PLLTX), U8.111 (GND_RCV1), U8.113 (GND_RCV3), U8.115 (GND_RX1), U8.118 (GND_TX1), U8.125 (GND_TX2), U8.128 (GND-ISO); also elsewhere on the board
ISET: R20.1, U8.19 (ISET)
LED3_3: U8.79 (LED3-3); also elsewhere on the board
LED6_2: U8.91 (LED6-2); also elsewhere on the board
LED6_3: U8.90 (LED6-3); also elsewhere on the board
LED7_0: U8.96 (LED7-0); also elsewhere on the board
LED7_2: U8.94 (LED7-2); also elsewhere on the board
LED7_3: U8.93 (LED7-3); also elsewhere on the board
LED8_0: U8.99 (LED8-0); also elsewhere on the board
LED8_2: U8.98 (LED8-2); also elsewhere on the board
LED8_3: U8.97 (LED8-3); also elsewhere on the board
unnamed: JP1.3, L1.2
RXM1: U8.117 (RXM1); also elsewhere on the board
RXM2: U8.127 (RXM2); also elsewhere on the board
RXM3: U8.6 (RXM3); also elsewhere on the board
RXM4: U8.16 (RXM4); also elsewhere on the board
RXM5: U8.24 (RXM5); also elsewhere on the board
RXM6: U8.34 (RXM6); also elsewhere on the board
RXM7: U8.41 (RXM7); also elsewhere on the board
RXM8: U8.51 (RXM8); also elsewhere on the board
RXP1: U8.116 (RXP1); also elsewhere on the board
RXP2: U8.126 (RXP2); also elsewhere on the board
RXP3: U8.5 (RXP3); also elsewhere on the board
RXP4: U8.15 (RXP4); also elsewhere on the board
RXP5: U8.23 (RXP5); also elsewhere on the board
RXP6: U8.33 (RXP6); also elsewhere on the board
RXP7: U8.40 (RXP7); also elsewhere on the board
RXP8: U8.50 (RXP8); also elsewhere on the board
TXM1: U8.120 (TXM1); also elsewhere on the board
TXM2: U8.124 (TXM2); also elsewhere on the board
TXM3: U8.9 (TXM3); also elsewhere on the board
TXM4: U8.13 (TXM4); also elsewhere on the board
TXM5: U8.27 (TXM5); also elsewhere on the board
TXM6: U8.31 (TXM6); also elsewhere on the board
TXM7: U8.44 (TXM7); also elsewhere on the board
TXM8: U8.48 (TXM8); also elsewhere on the board
TXP1: U8.119 (TXP1); also elsewhere on the board
TXP2: U8.123 (TXP2); also elsewhere on the board
TXP3: U8.8 (TXP3); also elsewhere on the board
TXP4: U8.12 (TXP4); also elsewhere on the board
TXP5: U8.26 (TXP5); also elsewhere on the board
TXP6: U8.30 (TXP6); also elsewhere on the board
TXP7: U8.43 (TXP7); also elsewhere on the board
TXP8: U8.47 (TXP8); also elsewhere on the board
VCCIO: C28.1, C36.1, C37.1, C38.1, JP1.2, U8.65 (VDD(I/O)), U8.77 (VDD(I/O)), U8.95 (VDD(I/O)); also elsewhere on the board

Notes on the sheet:
Locate near LDO output
Locate near VDD-PLLTX pin
Per-pin bypass
danjuliodesigns, LLC
Default VCCIO = 3.3V

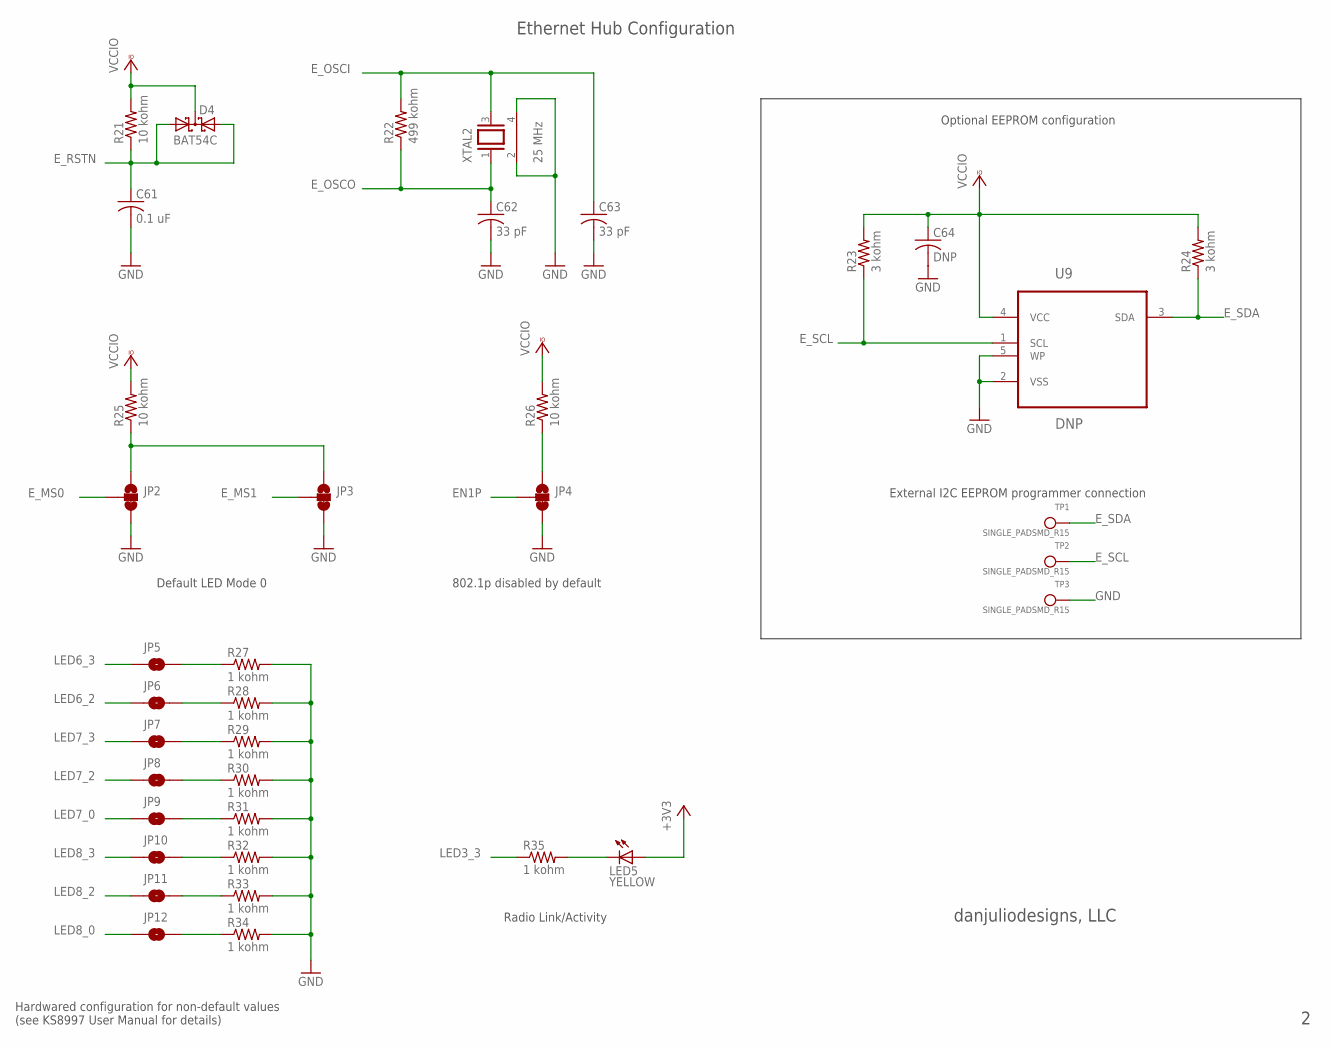
[picture p36: schematic firetirs.sch, sheet 5]

Parts:
C61: 0.1 uF; C0603
C62, C63: 33 pF; C0603
C64: DNP; C0603
D4: BAT54C; SOT23
JP2, JP3, JP4: JUMPER-PAD-3-2OF3_NC_BY_TRACE_SMALL; PAD-JUMPER-3-2OF3_NC_BY_TRACE_YES_SILK_FULL_BOX
JP5, JP6, JP7, JP8, JP9, JP10, JP11, JP12: JUMPER-PAD-2-NOYES_SILK; PAD-JUMPER-2-NO_YES_SILK
LED5: YELLOW; CHIPLED_0603
R21, R25, R26: 10 kohm; R0603
R22: 499 kohm; R0603
R23, R24: 3 kohm; R0603
R27, R28, R29, R30, R31, R32, R33, R34, R35: 1 kohm; R0603
TP1, TP2, TP3: SINGLE_PADSMD_R15; 1_5MM_R_SMD_PAD
U9: DNP; SOT95P270X145-5N
XTAL2: 25 MHz; CRYSTAL-3225

Connections:
+3V3: LED5.A; also elsewhere on the board
EN1P: JP4.2; also elsewhere on the board
E_MS0: JP2.2; also elsewhere on the board
E_MS1: JP3.2; also elsewhere on the board
E_OSCI: C63.1, R22.2, XTAL2.3; also elsewhere on the board
E_OSCO: C62.1, R22.1, XTAL2.1; also elsewhere on the board
E_RSTN: C61.1, D4.1 (A1), D4.2 (A2), R21.1; also elsewhere on the board
E_SCL: R23.1, TP2.P$1, U9.1 (SCL); also elsewhere on the board
E_SDA: R24.1, TP1.P$1, U9.3 (SDA); also elsewhere on the board
GND: C61.2, C62.2, C63.2, C64.2, JP2.3, JP3.3, JP4.3, R27.2, R28.2, R29.2, R30.2, R31.2, R32.2, R33.2, R34.2, TP3.P$1, U9.2 (VSS), U9.5 (WP), XTAL2.2, XTAL2.4; also elsewhere on the board
LED3_3: R35.1; also elsewhere on the board
LED6_2: JP6.1; also elsewhere on the board
LED6_3: JP5.1; also elsewhere on the board
LED7_0: JP9.1; also elsewhere on the board
LED7_2: JP8.1; also elsewhere on the board
LED7_3: JP7.1; also elsewhere on the board
LED8_0: JP12.1; also elsewhere on the board
LED8_2: JP11.1; also elsewhere on the board
LED8_3: JP10.1; also elsewhere on the board
unnamed: JP2.1, JP3.1, R25.1
unnamed: JP4.1, R26.1
unnamed: JP5.2, R27.1
unnamed: JP6.2, R28.1
unnamed: JP7.2, R29.1
unnamed: JP8.2, R30.1
unnamed: JP9.2, R31.1
unnamed: JP10.2, R32.1
unnamed: JP11.2, R33.1
unnamed: JP12.2, R34.1
unnamed: LED5.C, R35.2
VCCIO: C64.1, D4.3 (CC), R21.2, R23.2, R24.2, R25.2, R26.2, U9.4 (VCC); also elsewhere on the board

Notes on the sheet:
Radio Link/Activity
Optional EEPROM configuration
Default LED Mode 0
802.1p disabled by default
Hardwared configuration for non-default values (see KS8997 User Manual for details)
External I2C EEPROM programmer connection
danjuliodesigns, LLC
Ethernet Hub Configuration

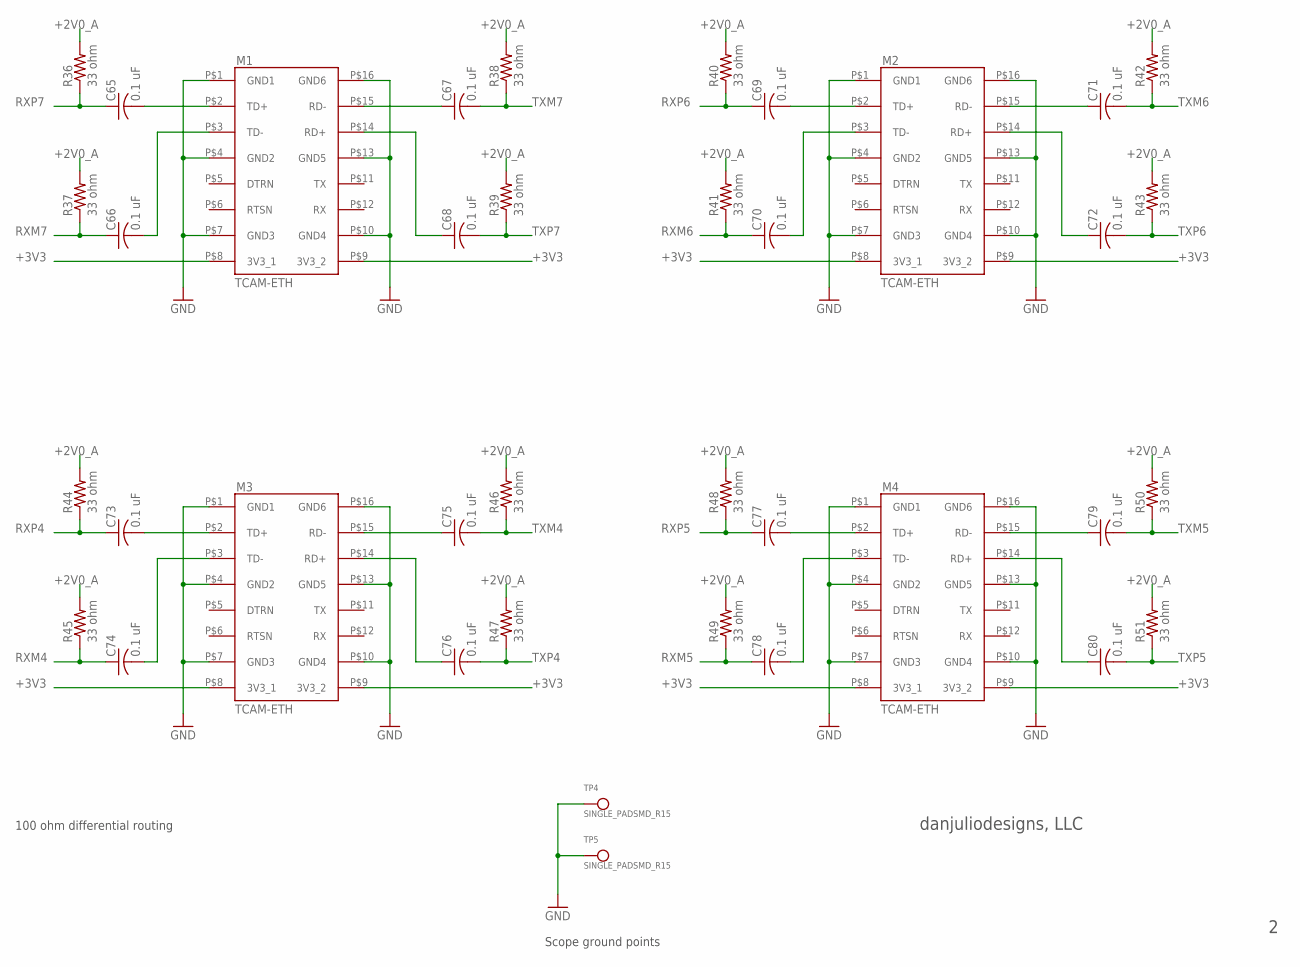
[picture p37: schematic firetirs.sch, sheet 6]

Parts:
C65, C66, C67, C68, C69, C70, C71, C72, C73, C74, C75, C76, C77, C78, C79, C80: 0.1 uF; C0603
M1, M2, M3, M4: TCAM-ETH
R36, R37, R38, R39, R40, R41, R42, R43, R44, R45, R46, R47, R48, R49, R50, R51: 33 ohm; R0603
TP4, TP5: SINGLE_PADSMD_R15; 1_5MM_R_SMD_PAD

Connections:
+2V0_A: R36.2, R37.2, R38.2, R39.2, R40.2, R41.2, R42.2, R43.2, R44.2, R45.2, R46.2, R47.2, R48.2, R49.2, R50.2, R51.2; also elsewhere on the board
+3V3: M1.P$8 (3V3_1), M1.P$9 (3V3_2), M2.P$8 (3V3_1), M2.P$9 (3V3_2), M3.P$8 (3V3_1), M3.P$9 (3V3_2), M4.P$8 (3V3_1), M4.P$9 (3V3_2); also elsewhere on the board
GND: M1.P$1 (GND1), M1.P$4 (GND2), M1.P$7 (GND3), M1.P$10 (GND4), M1.P$13 (GND5), M1.P$16 (GND6), M2.P$1 (GND1), M2.P$4 (GND2), M2.P$7 (GND3), M2.P$10 (GND4), M2.P$13 (GND5), M2.P$16 (GND6), M3.P$1 (GND1), M3.P$4 (GND2), M3.P$7 (GND3), M3.P$10 (GND4), M3.P$13 (GND5), M3.P$16 (GND6), M4.P$1 (GND1), M4.P$4 (GND2), M4.P$7 (GND3), M4.P$10 (GND4), M4.P$13 (GND5), M4.P$16 (GND6), TP4.P$1, TP5.P$1; also elsewhere on the board
unnamed: C70.2, M2.P$3 (TD-)
unnamed: C66.2, M1.P$3 (TD-)
unnamed: C65.2, M1.P$2 (TD+)
unnamed: C69.2, M2.P$2 (TD+)
unnamed: C71.1, M2.P$15 (RD-)
unnamed: C67.1, M1.P$15 (RD-)
unnamed: C68.1, M1.P$14 (RD+)
unnamed: C72.1, M2.P$14 (RD+)
unnamed: C74.2, M3.P$3 (TD-)
unnamed: C73.2, M3.P$2 (TD+)
unnamed: C75.1, M3.P$15 (RD-)
unnamed: C76.1, M3.P$14 (RD+)
unnamed: C78.2, M4.P$3 (TD-)
unnamed: C77.2, M4.P$2 (TD+)
unnamed: C79.1, M4.P$15 (RD-)
unnamed: C80.1, M4.P$14 (RD+)
RXM4: C74.1, R45.1; also elsewhere on the board
RXM5: C78.1, R49.1; also elsewhere on the board
RXM6: C70.1, R41.1; also elsewhere on the board
RXM7: C66.1, R37.1; also elsewhere on the board
RXP4: C73.1, R44.1; also elsewhere on the board
RXP5: C77.1, R48.1; also elsewhere on the board
RXP6: C69.1, R40.1; also elsewhere on the board
RXP7: C65.1, R36.1; also elsewhere on the board
TXM4: C75.2, R46.1; also elsewhere on the board
TXM5: C79.2, R50.1; also elsewhere on the board
TXM6: C71.2, R42.1; also elsewhere on the board
TXM7: C67.2, R38.1; also elsewhere on the board
TXP4: C76.2, R47.1; also elsewhere on the board
TXP5: C80.2, R51.1; also elsewhere on the board
TXP6: C72.2, R43.1; also elsewhere on the board
TXP7: C68.2, R39.1; also elsewhere on the board

Notes on the sheet:
100 ohm differential routing
danjuliodesigns, LLC
Scope ground points
