jthompson2710/FireTIRS/hardware/pcb_assembly/design/firetirs.brd

## EAGLE design hardware/pcb_assembly/design/firetirs.brd (continued)

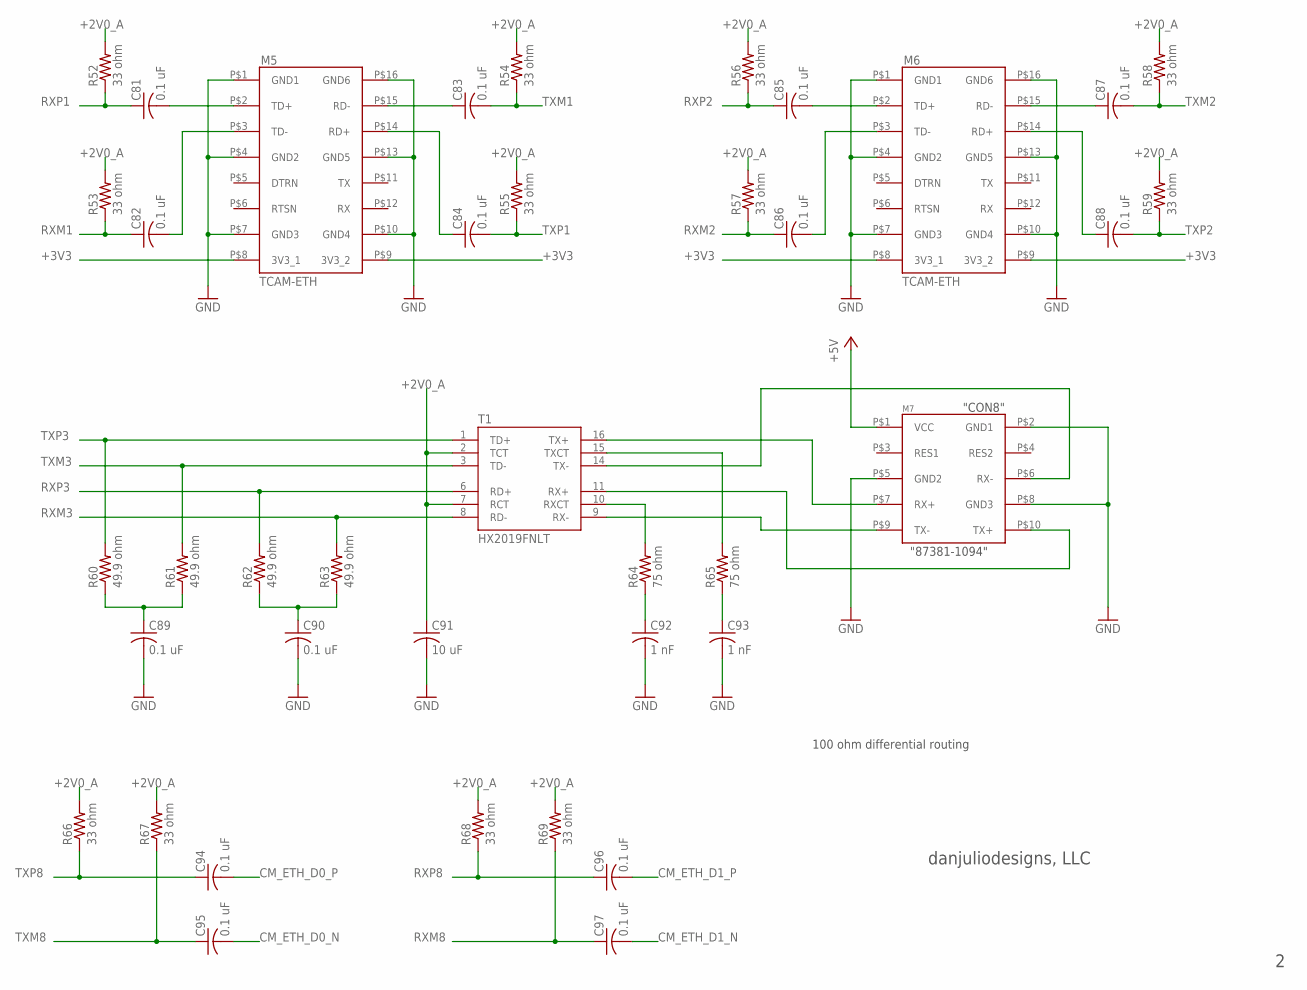
[picture p38: schematic firetirs.sch, sheet 7]

Parts:
C81, C82, C83, C84, C85, C86, C87, C88, C89, C90, C94, C95, C96, C97: 0.1 uF; C0603
C91: 10 uF; C0603
C92, C93: 1 nF; C0603
M5, M6: TCAM-ETH
M7: FREEWAVE_Z9_PC
R52, R53, R54, R55, R56, R57, R58, R59, R66, R67, R68, R69: 33 ohm; R0603
R60, R61, R62, R63: 49.9 ohm; R0603
R64, R65: 75 ohm; R0603
T1: HX2019FNLT; XFMR_HX2019FNLT

Connections:
+2V0_A: C91.1, R52.2, R53.2, R54.2, R55.2, R56.2, R57.2, R58.2, R59.2, R66.2, R67.2, R68.2, R69.2, T1.2 (TCT), T1.7 (RCT); also elsewhere on the board
+3V3: M5.P$8 (3V3_1), M5.P$9 (3V3_2), M6.P$8 (3V3_1), M6.P$9 (3V3_2); also elsewhere on the board
+5V: M7.P$1 (VCC); also elsewhere on the board
CM_ETH_D0_N: C95.2; also elsewhere on the board
CM_ETH_D0_P: C94.2; also elsewhere on the board
CM_ETH_D1_N: C97.2; also elsewhere on the board
CM_ETH_D1_P: C96.2; also elsewhere on the board
GND: C89.2, C90.2, C91.2, C92.2, C93.2, M5.P$1 (GND1), M5.P$4 (GND2), M5.P$7 (GND3), M5.P$10 (GND4), M5.P$13 (GND5), M5.P$16 (GND6), M6.P$1 (GND1), M6.P$4 (GND2), M6.P$7 (GND3), M6.P$10 (GND4), M6.P$13 (GND5), M6.P$16 (GND6), M7.P$2 (GND1), M7.P$5 (GND2), M7.P$8 (GND3); also elsewhere on the board
unnamed: C81.2, M5.P$2 (TD+)
unnamed: C82.2, M5.P$3 (TD-)
unnamed: C85.2, M6.P$2 (TD+)
unnamed: C86.2, M6.P$3 (TD-)
unnamed: C87.1, M6.P$15 (RD-)
unnamed: C83.1, M5.P$15 (RD-)
unnamed: C84.1, M5.P$14 (RD+)
unnamed: C88.1, M6.P$14 (RD+)
unnamed: C89.1, R60.1, R61.1
unnamed: C90.1, R62.1, R63.1
unnamed: C92.1, R64.1
unnamed: C93.1, R65.1
unnamed: R64.2, T1.10 (RXCT)
unnamed: R65.2, T1.15 (TXCT)
unnamed: M7.P$9 (TX-), T1.9 (RX-)
unnamed: M7.P$10 (TX+), T1.11 (RX+)
unnamed: M7.P$6 (RX-), T1.14 (TX-)
unnamed: M7.P$7 (RX+), T1.16 (TX+)
RXM1: C82.1, R53.1; also elsewhere on the board
RXM2: C86.1, R57.1; also elsewhere on the board
RXM3: R63.2, T1.8 (RD-); also elsewhere on the board
RXM8: C97.1, R69.1; also elsewhere on the board
RXP1: C81.1, R52.1; also elsewhere on the board
RXP2: C85.1, R56.1; also elsewhere on the board
RXP3: R62.2, T1.6 (RD+); also elsewhere on the board
RXP8: C96.1, R68.1; also elsewhere on the board
TXM1: C83.2, R54.1; also elsewhere on the board
TXM2: C87.2, R58.1; also elsewhere on the board
TXM3: R61.2, T1.3 (TD-); also elsewhere on the board
TXM8: C95.1, R67.1; also elsewhere on the board
TXP1: C84.2, R55.1; also elsewhere on the board
TXP2: C88.2, R59.1; also elsewhere on the board
TXP3: R60.2, T1.1 (TD+); also elsewhere on the board
TXP8: C94.1, R66.1; also elsewhere on the board

Notes on the sheet:
100 ohm differential routing
danjuliodesigns, LLC
"CON8"
"87381-1094"

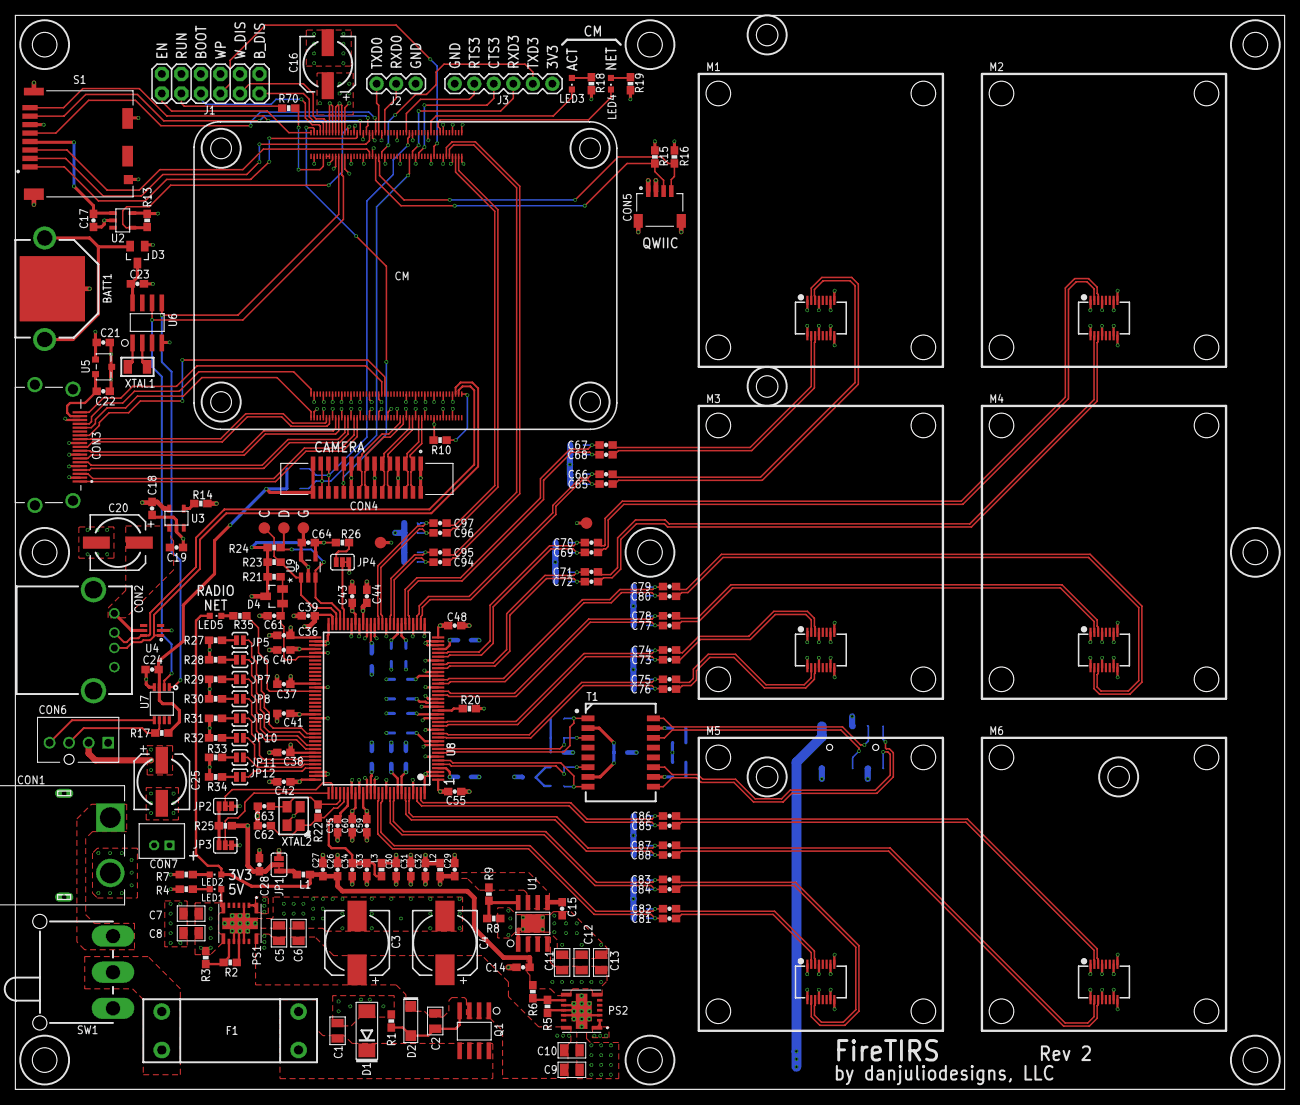
[picture p39: board firetirs.brd from above]

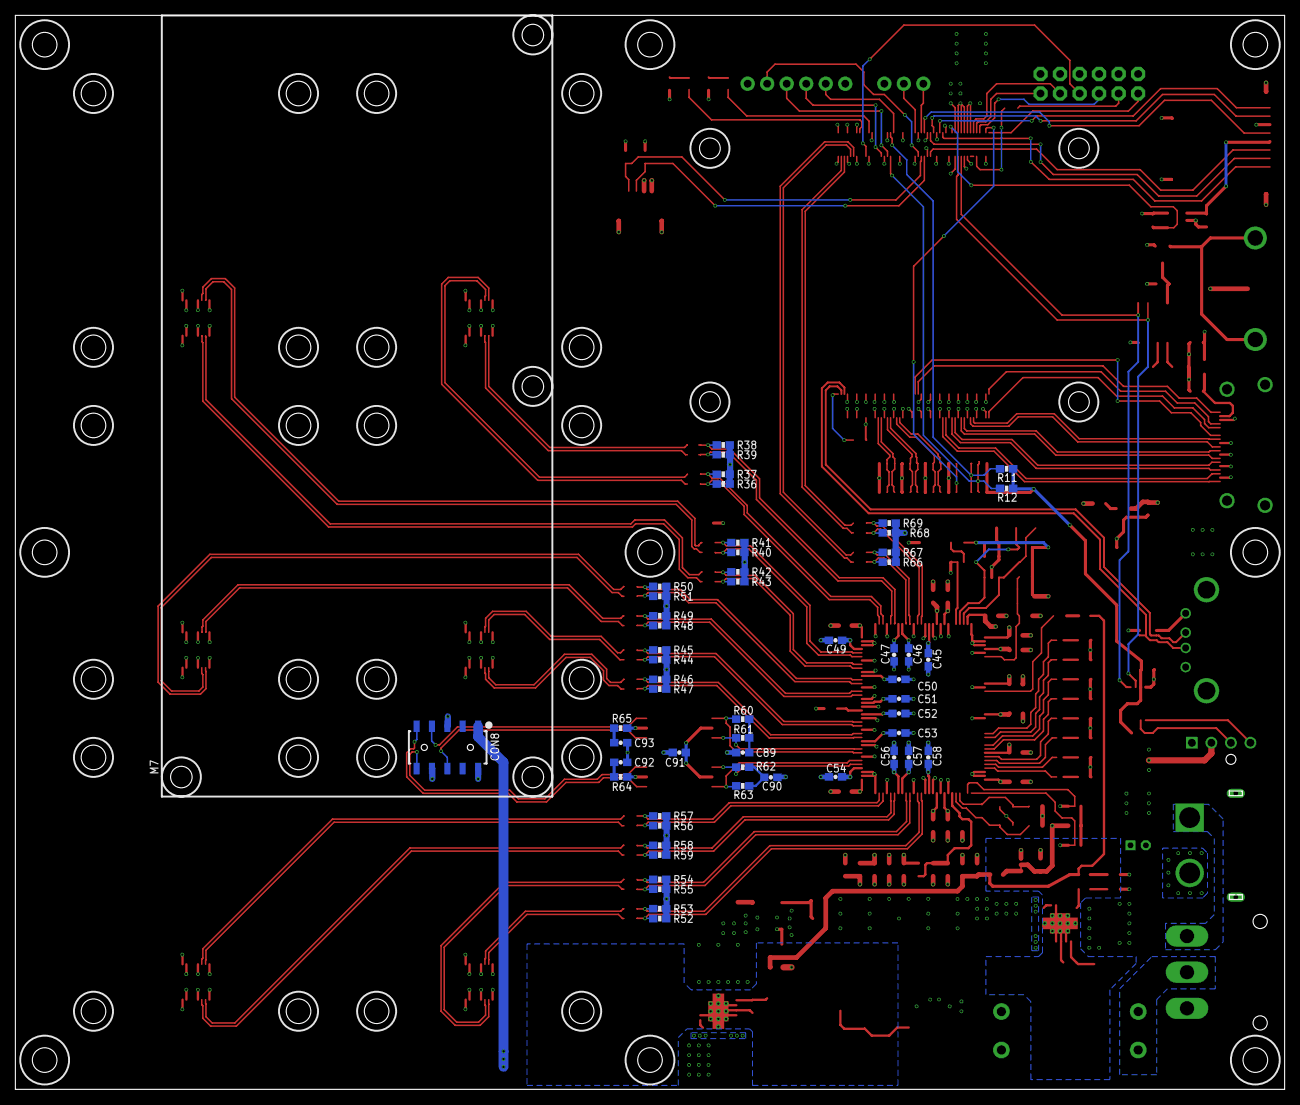
[picture p40: board firetirs.brd from below]

Board: 4 copper layers, 165.1 x 139.7 mm, 233 parts (54 on the bottom side), 181 nets.
