jthompson2710/FireTIRS/(commit log)

2024-07-04 Initial checkin of electronics documentation
    [FireTIRS_rev2_bom.xlsx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]
2025-01-29 Correct ethernet cable wiring table
